annegautham/STM/README.md

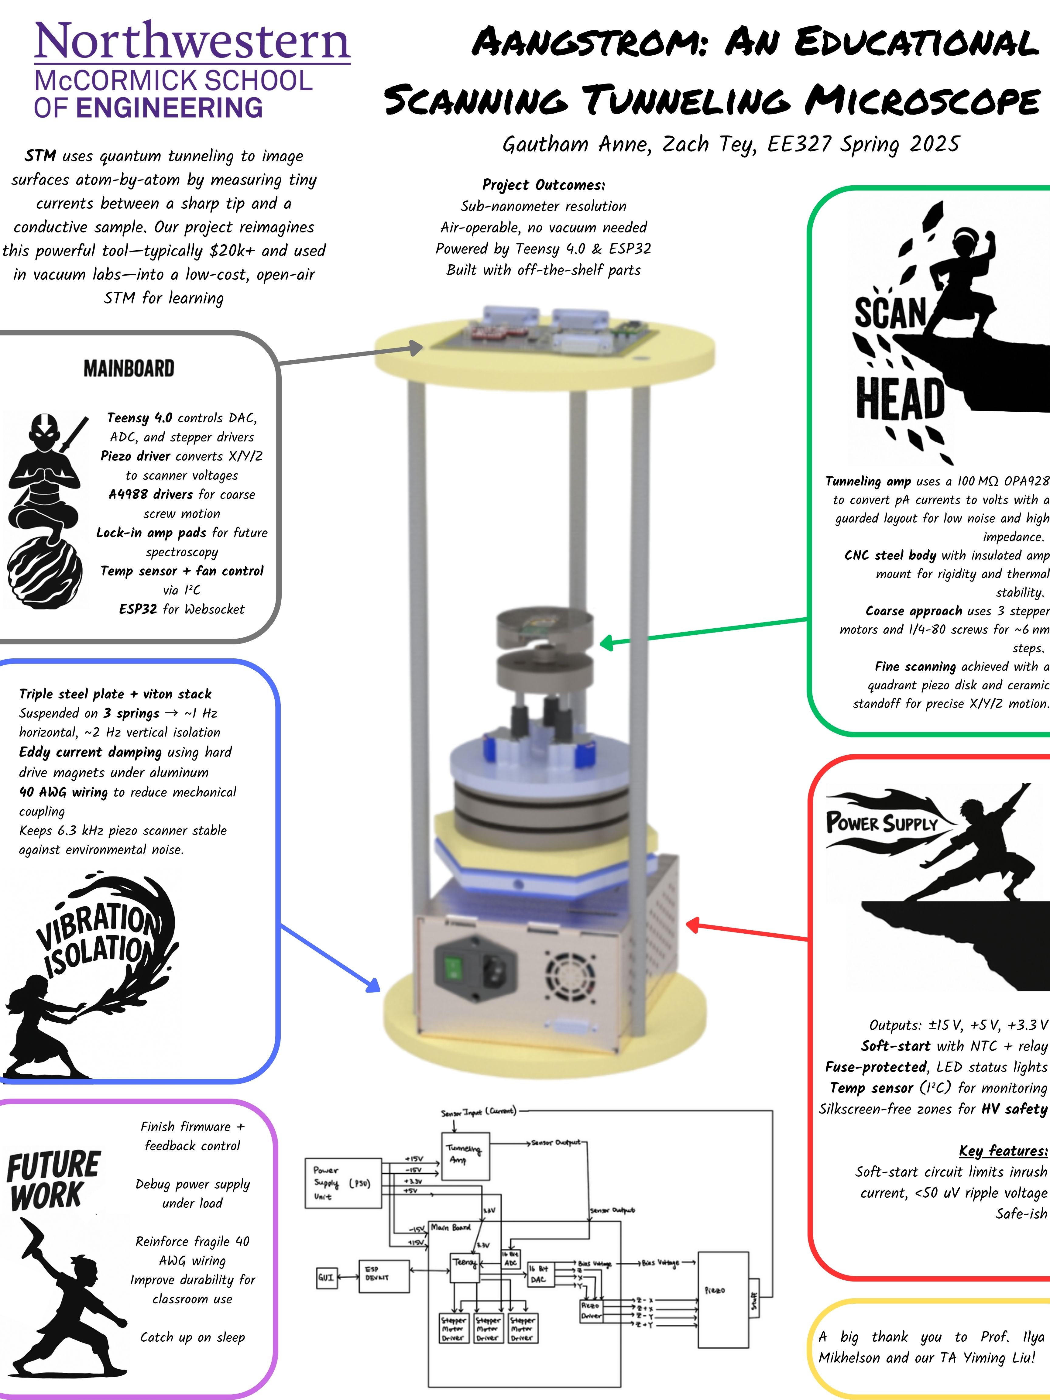
[picture p1: EE327FinalPoster.jpg]

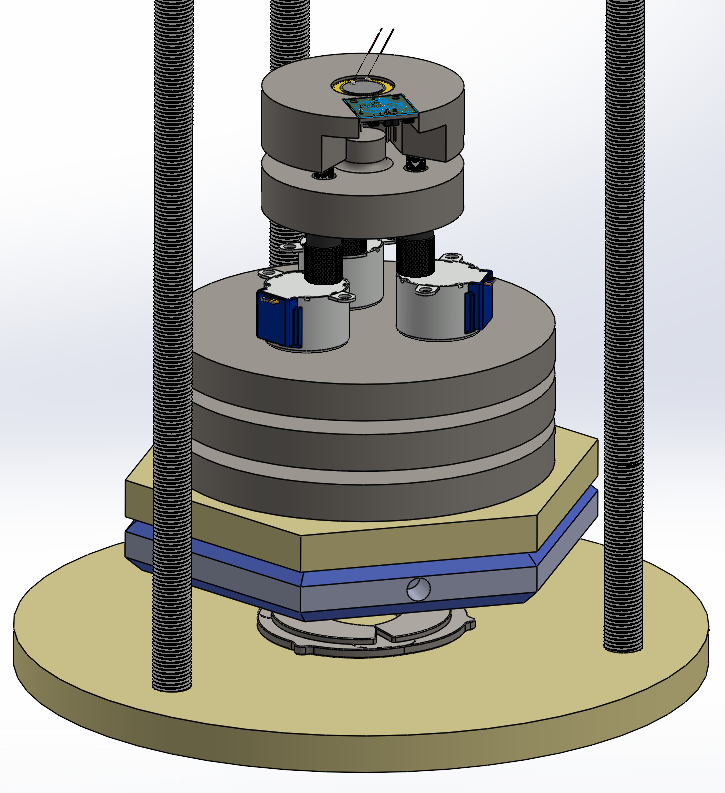
[picture p2: setup.png]
