annegautham/STM/Scan Head/28-BYJ48/28BYJ-48 stepper motor 5VDC.jpg

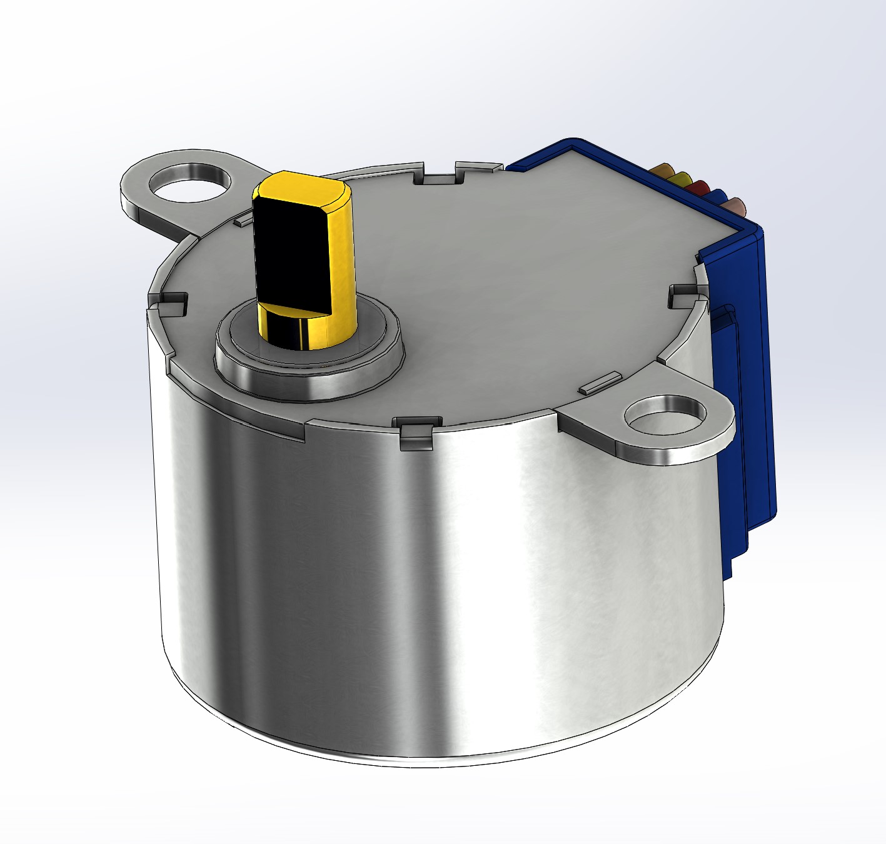
Scan Head/28-BYJ48/28BYJ-48 stepper motor 5VDC.jpg
