annegautham/STM/Scan Head/28-BYJ48/28BYJ-48 stepper motor ASSEMBLY.SLDASM

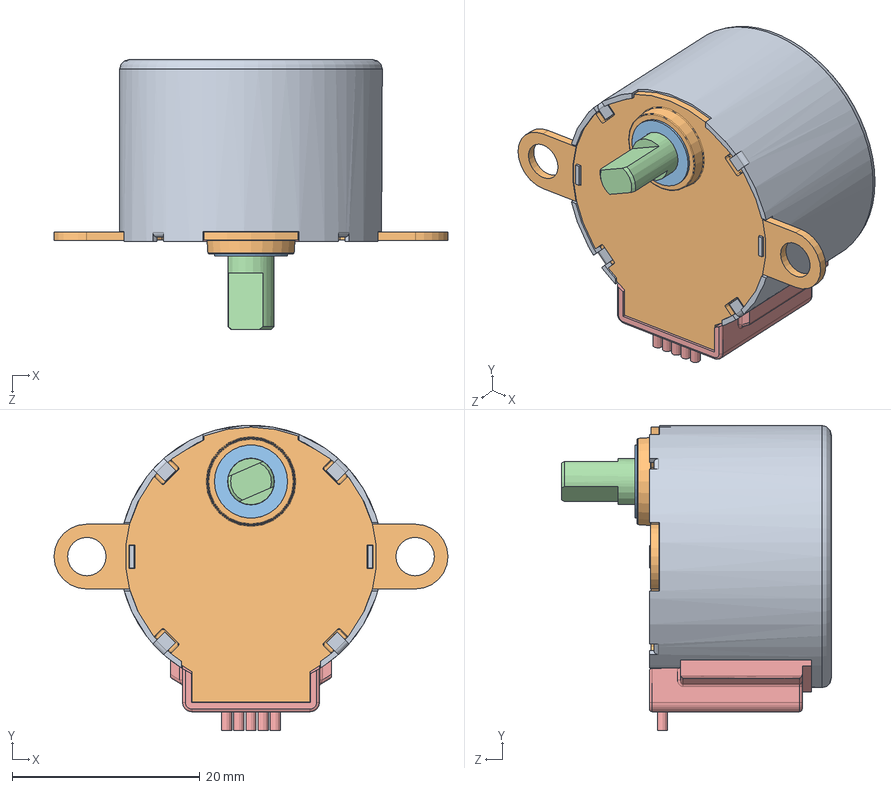
[picture p4: CAD file, 2025-05-25]
Scan Head/28-BYJ48/28BYJ-48 stepper motor ASSEMBLY.SLDASM
42.0 x 32.5 x 28.8 mm
28BYJ-48 body
28BYJ-48 cover plate
Teflon D8d5
28BYJ-48 shaft
28BYJ-48 plastic
