annegautham/STM/Mainboard/casing.SLDPRT

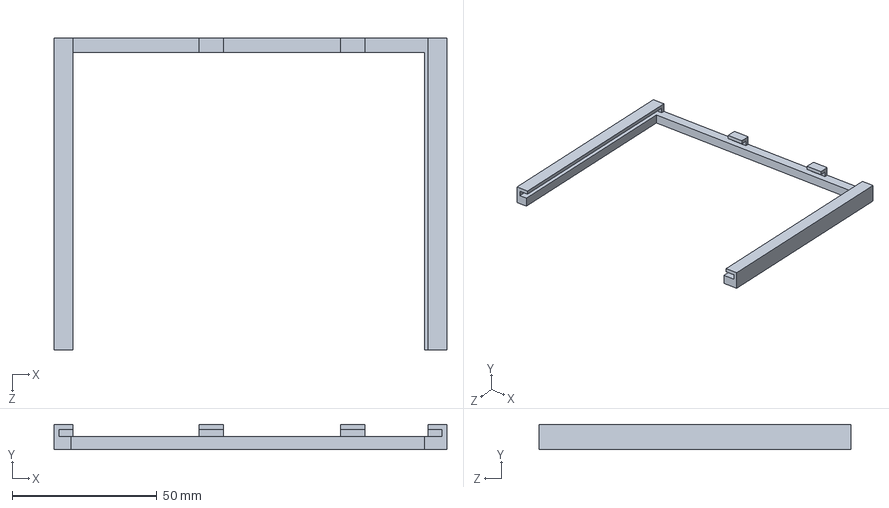
[picture p5: CAD file, 2025-06-02]
Mainboard/casing.SLDPRT
135.6 x 8.75 x 107.8 mm
