annegautham/STM/Power_Supply/CAD/Power_Supply_Case.SLDPRT

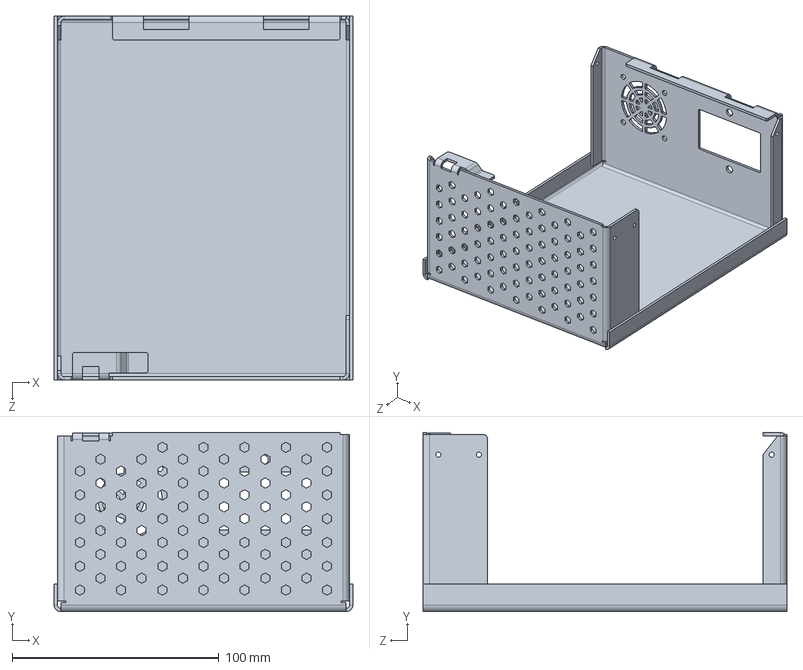
[picture p6: CAD file, 2025-06-02]
Power_Supply/CAD/Power_Supply_Case.SLDPRT
144.6 x 86.6 x 176.0 mm
