annegautham/STM/Scan Head/28-BYJ48/28BYJ-48 cover plate.SLDPRT

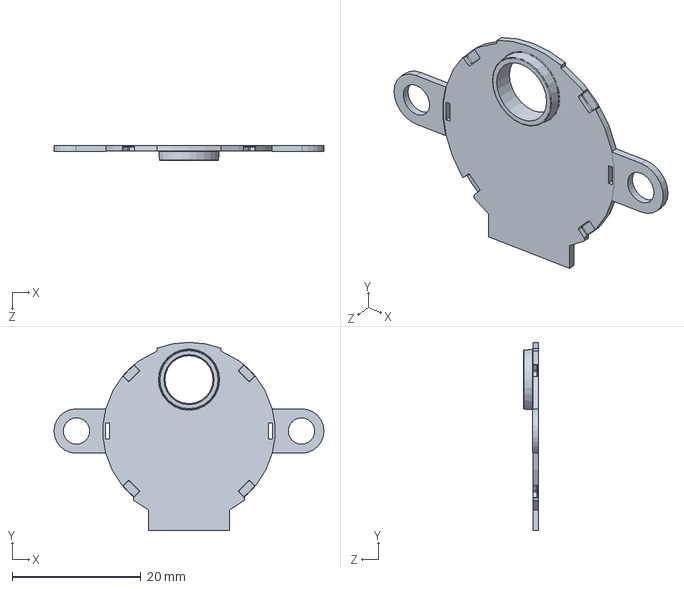
[picture p7: CAD file, 2025-05-25]
Scan Head/28-BYJ48/28BYJ-48 cover plate.SLDPRT
42.0 x 29.3 x 2.35 mm
