annegautham/STM/Scan Head/Top.SLDPRT

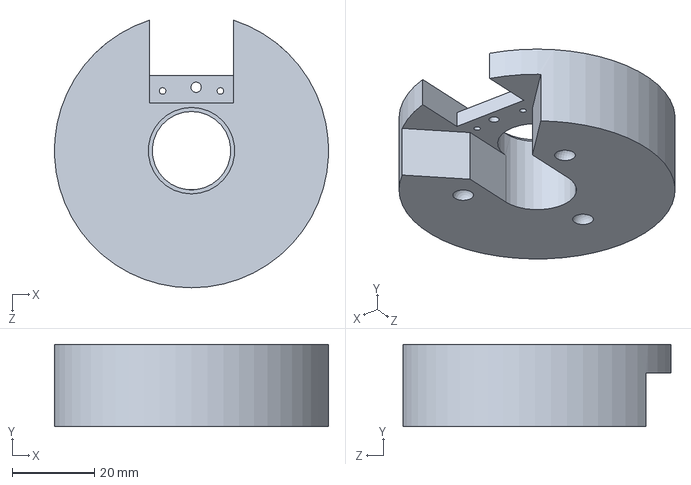
[picture p8: CAD file, 2025-05-30]
Scan Head/Top.SLDPRT
66.6 x 20.0 x 65.0 mm
