annegautham/STM/support_mot_pap.SLDPRT

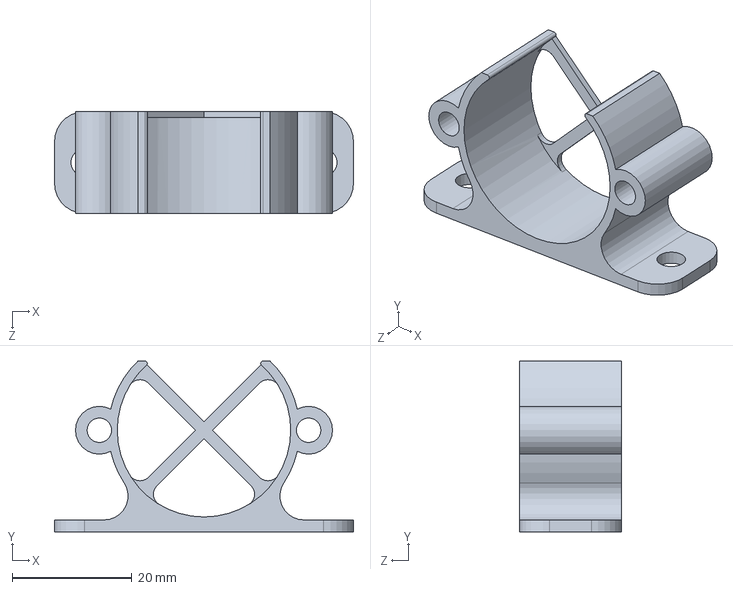
[picture p9: CAD file, 2025-11-16]
support_mot_pap.SLDPRT
50.0 x 28.6 x 17.0 mm
