annegautham/STM/Vibration Isolation/steelEyeM10x20.step

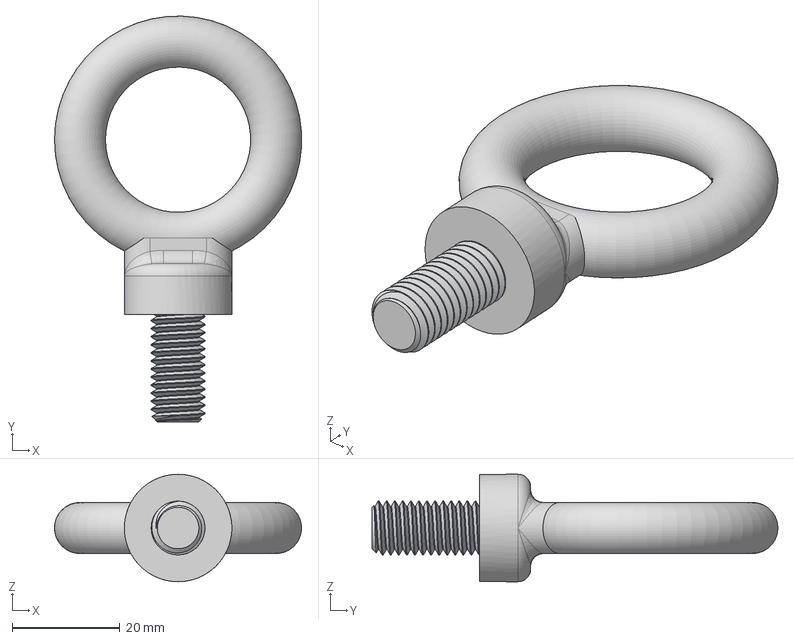
[picture p10: CAD file, 2025-06-02]
Vibration Isolation/steelEyeM10x20.step
45.9 x 75.5 x 20.0 mm
