annegautham/STM/Power_Supply/CAD/TopCover.SLDPRT

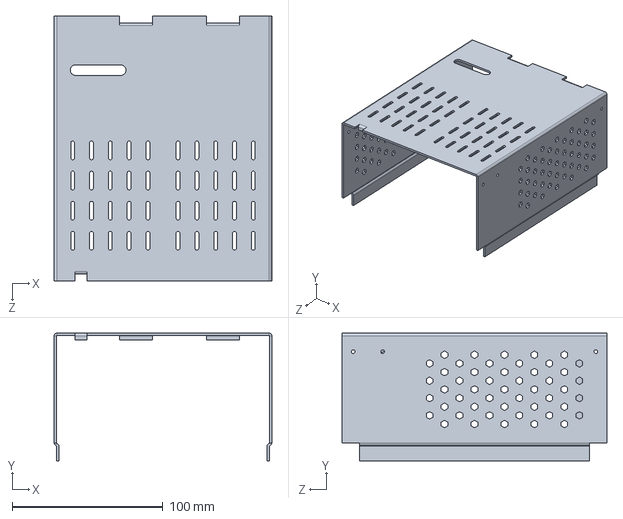
[picture p11: CAD file, 2025-05-28]
Power_Supply/CAD/TopCover.SLDPRT
144.6 x 85.0 x 176.0 mm
