annegautham/STM/Scan Head/Base.SLDPRT

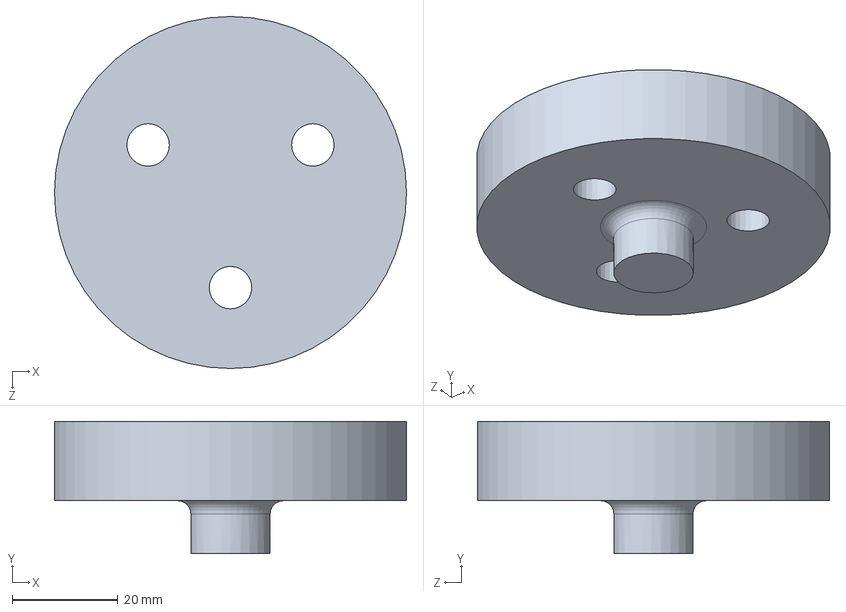
[picture p12: CAD file, 2025-05-25]
Scan Head/Base.SLDPRT
66.6 x 25.0 x 66.6 mm
