annegautham/STM/spider.SLDPRT

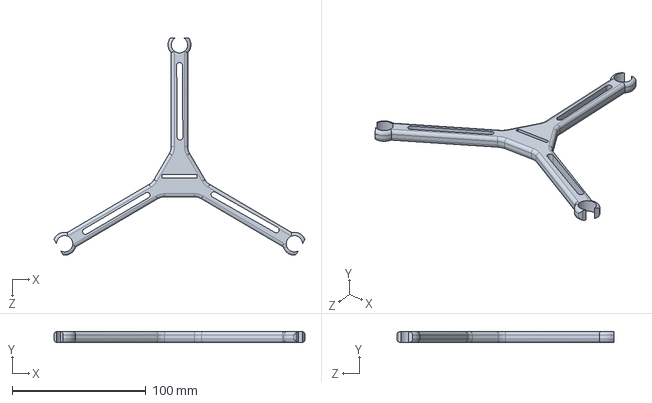
[picture p13: CAD file, 2025-11-16]
spider.SLDPRT
188.0 x 8.00 x 162.8 mm
