annegautham/STM/Vibration Isolation/mdf_ground.SLDPRT

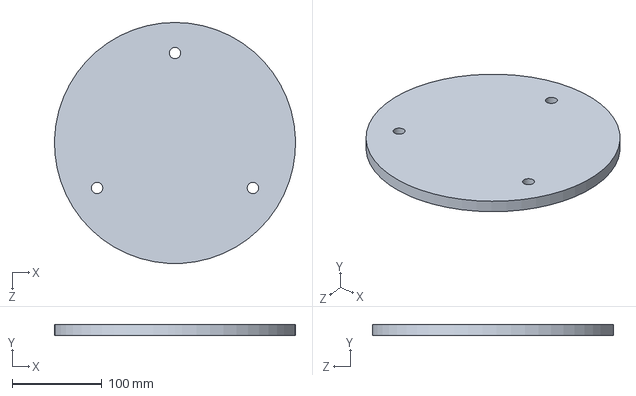
[picture p14: CAD file, 2025-06-02]
Vibration Isolation/mdf_ground.SLDPRT
267.9 x 12.7 x 268.0 mm
