annegautham/STM/Power_Supply/CAD/Flat pattern - Power_Supply_Case.DXF

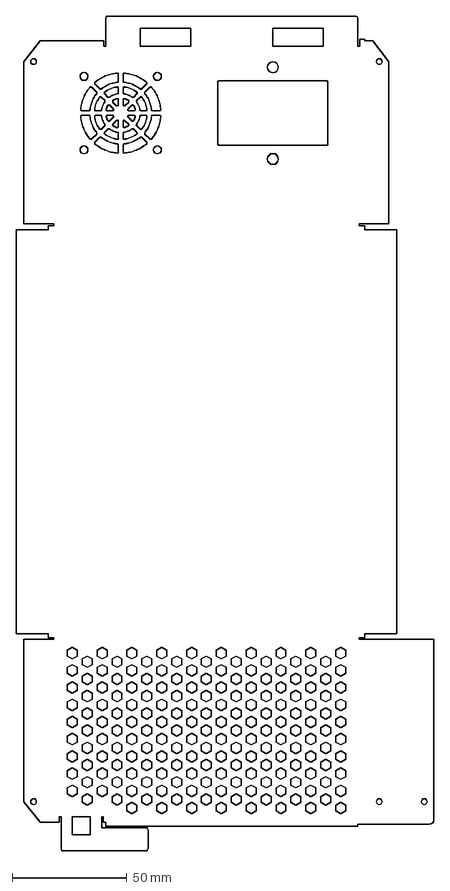
[picture p15: CAD file, 2025-04-13]
Power_Supply/CAD/Flat pattern - Power_Supply_Case.DXF
182.1 x 363.5 mm
