annegautham/STM/Scan Head/base_interconnect.SLDPRT

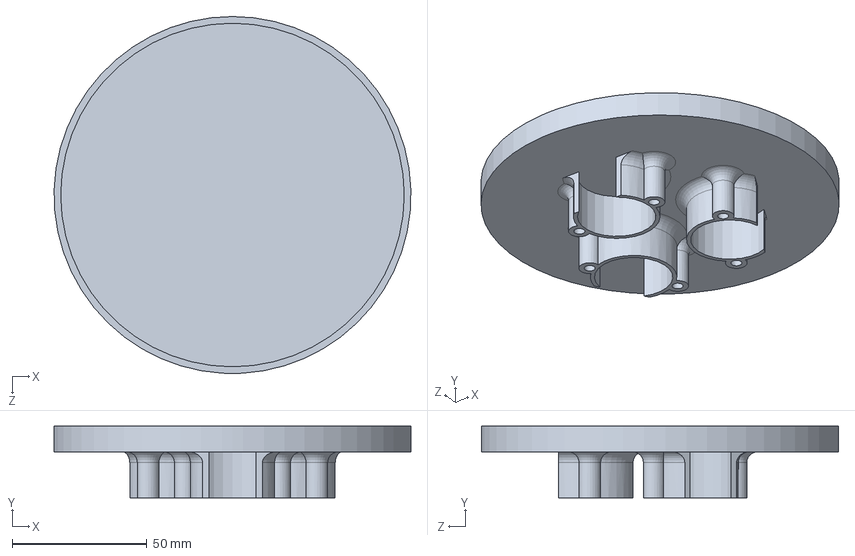
[picture p16: CAD file, 2025-05-25]
Scan Head/base_interconnect.SLDPRT
132.2 x 26.5 x 132.2 mm
