annegautham/STM/Vibration Isolation/eyehook.SLDPRT

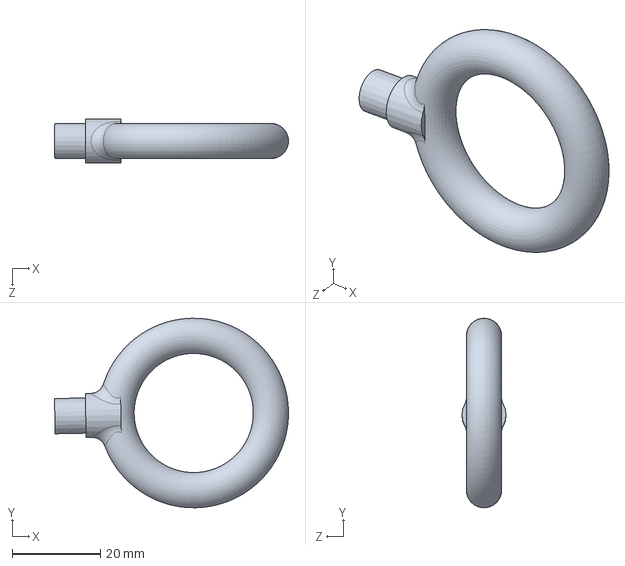
[picture p17: CAD file, 2025-06-02]
Vibration Isolation/eyehook.SLDPRT
53.1 x 43.0 x 10.0 mm
