annegautham/STM/Power_Supply/CAD/Flat pattern - TopCover.DXF

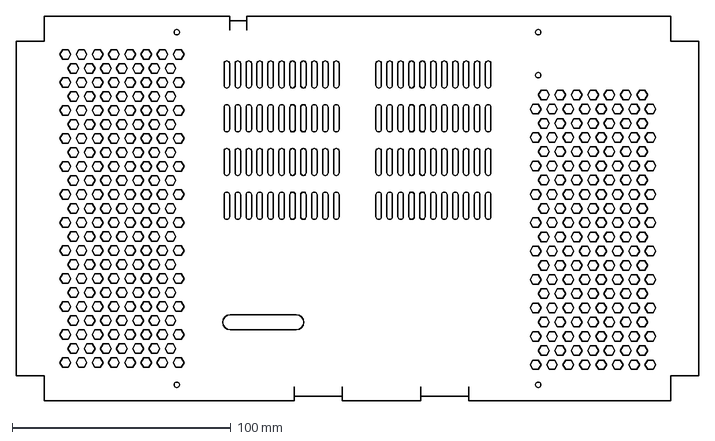
[picture p18: CAD file, 2025-04-13]
Power_Supply/CAD/Flat pattern - TopCover.DXF
311.9 x 176.0 mm
