annegautham/STM/Scan Head/28-BYJ48/28BYJ-48 body.SLDPRT

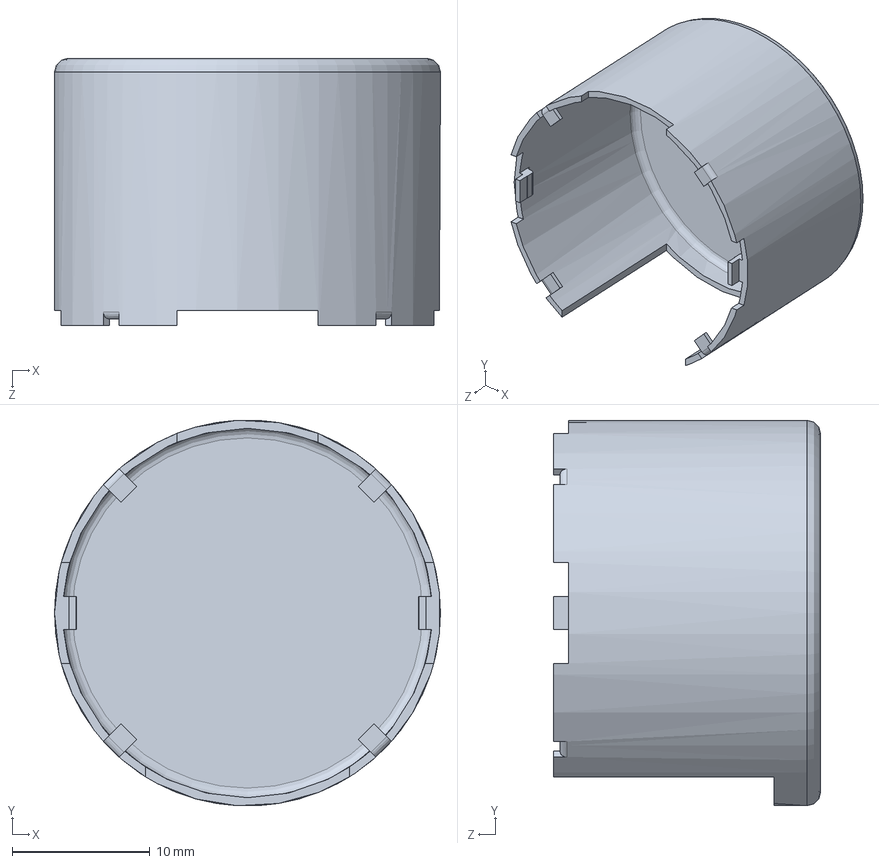
[picture p19: CAD file, 2025-04-18]
Scan Head/28-BYJ48/28BYJ-48 body.SLDPRT
28.0 x 28.0 x 19.4 mm
