annegautham/STM/Scan Head/collet.SLDPRT

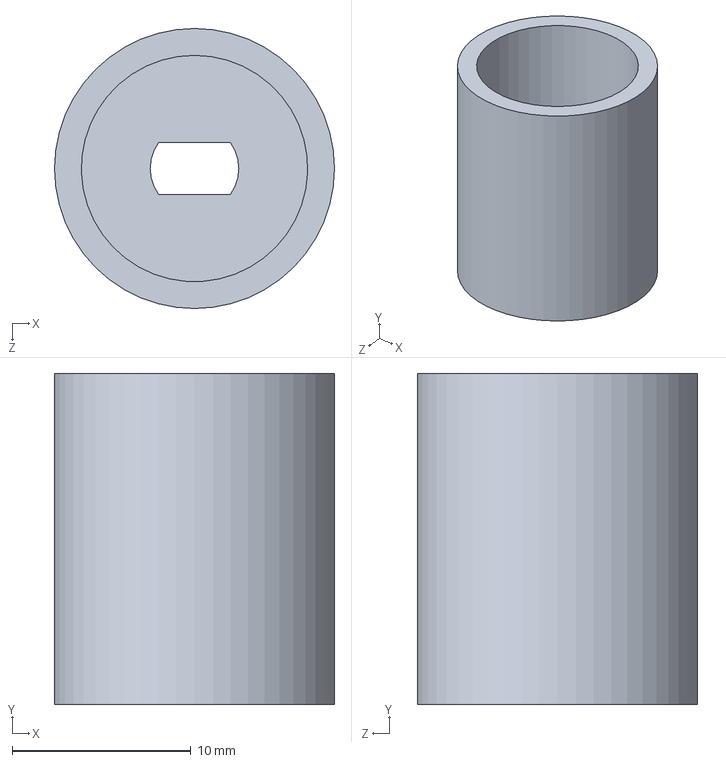
[picture p20: CAD file, 2025-05-18]
Scan Head/collet.SLDPRT
15.7 x 18.5 x 15.7 mm
