annegautham/STM/Power_Supply/CAD/Power Entry AC 10A 250V IEC320 C14 Illuminated.STEP

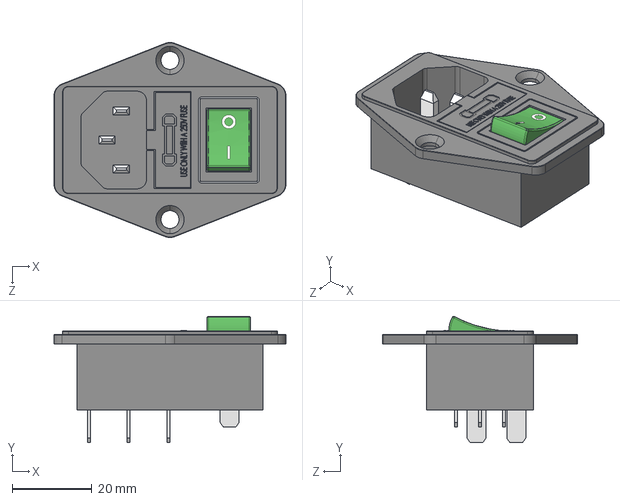
[picture p21: CAD file, 2025-04-04]
Power_Supply/CAD/Power Entry AC 10A 250V IEC320 C14 Illuminated.STEP
58.3 x 31.7 x 49.0 mm
