annegautham/STM/Scan Head/28-BYJ48/28BYJ-48 plastic.SLDPRT

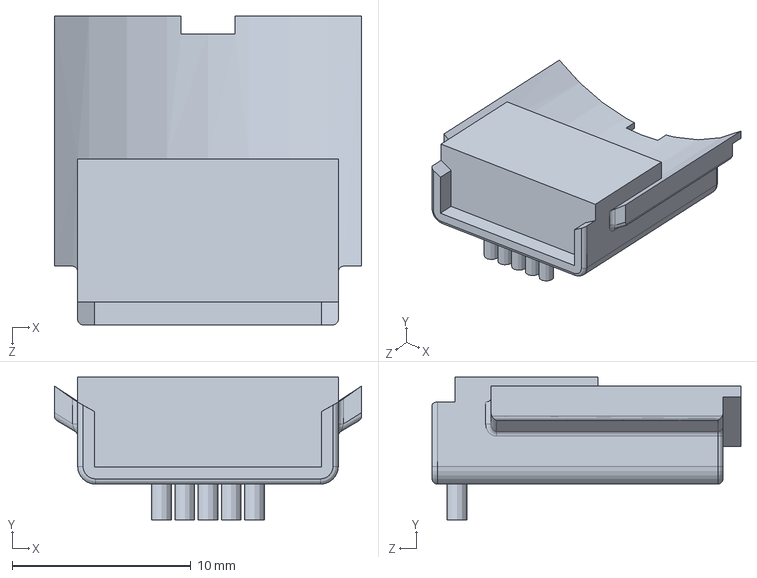
[picture p22: CAD file, 2025-04-18]
Scan Head/28-BYJ48/28BYJ-48 plastic.SLDPRT
17.2 x 8.00 x 17.3 mm
