annegautham/STM/Vibration Isolation/tipGuard.SLDPRT

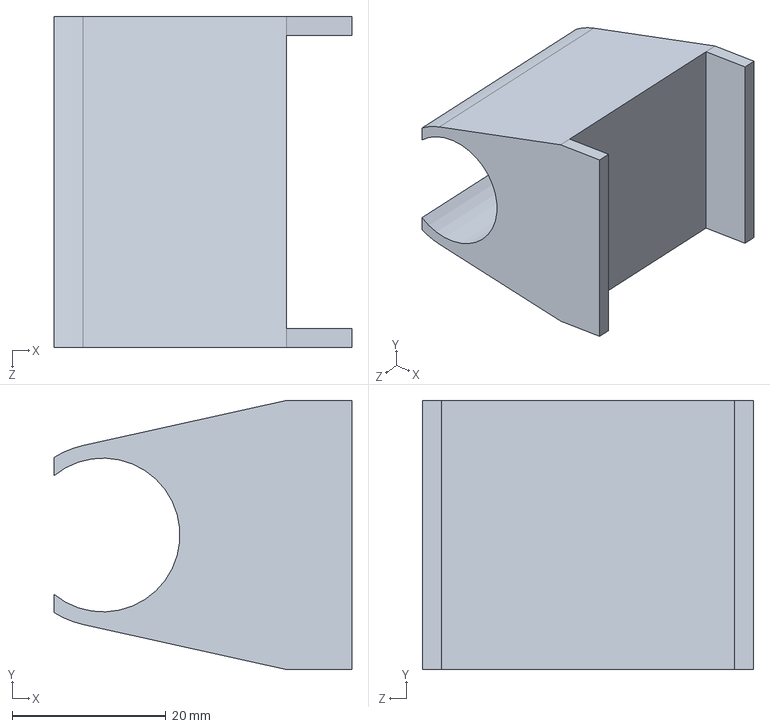
[picture p24: CAD file, 2025-05-29]
Vibration Isolation/tipGuard.SLDPRT
38.7 x 35.0 x 43.1 mm
