annegautham/STM/Power_Supply/CAD/40x40x10 DC Fan.SLDPRT

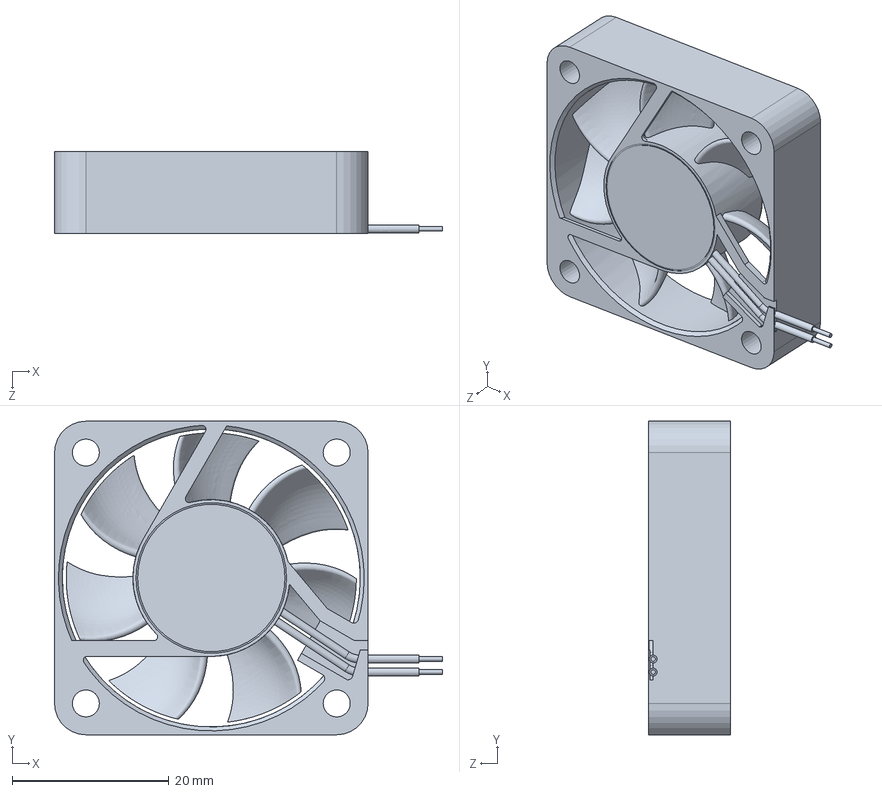
[picture p25: CAD file, 2025-04-04]
Power_Supply/CAD/40x40x10 DC Fan.SLDPRT
49.5 x 40.0 x 10.5 mm
