annegautham/STM/Scan Head/28-BYJ48/28BYJ-48 shaft.SLDPRT

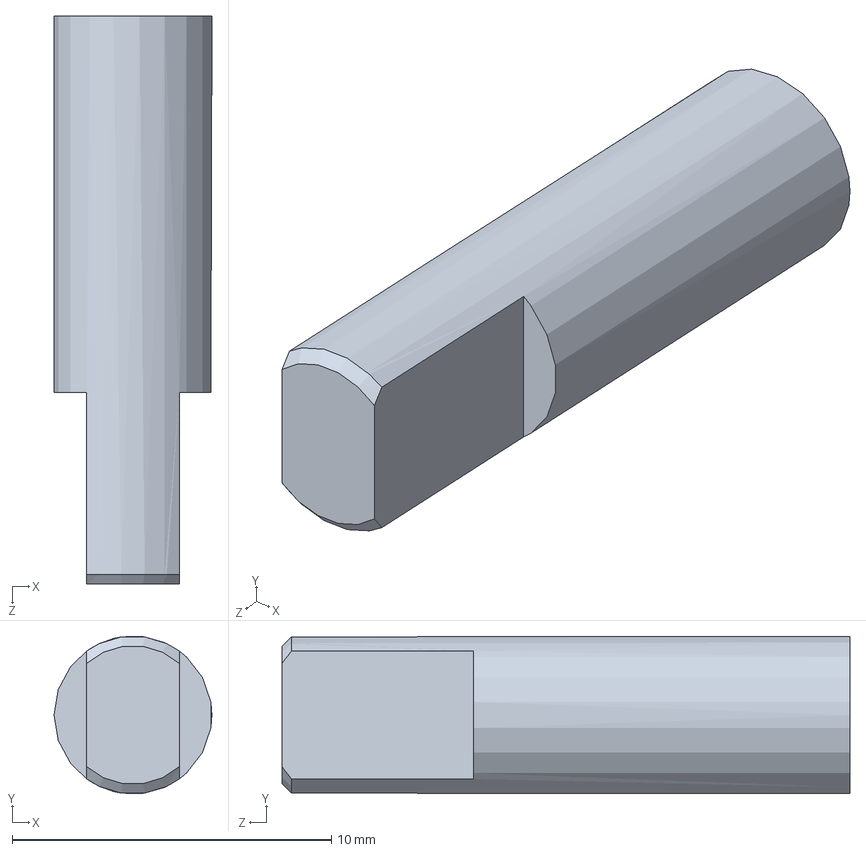
[picture p26: CAD file, 2025-04-18]
Scan Head/28-BYJ48/28BYJ-48 shaft.SLDPRT
4.95 x 4.93 x 17.8 mm
