annegautham/STM/Scan Head/tunneling_amp_insulation.SLDPRT

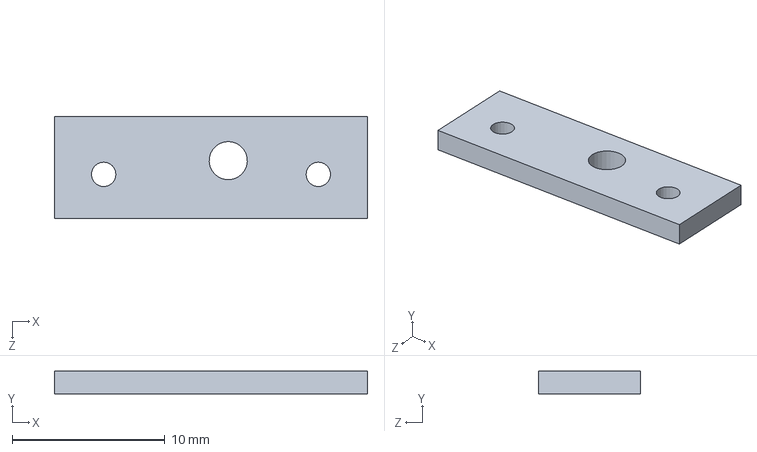
[picture p27: CAD file, 2025-04-23]
Scan Head/tunneling_amp_insulation.SLDPRT
20.5 x 1.50 x 6.70 mm
