annegautham/STM/Vibration Isolation/mdf_base.SLDPRT

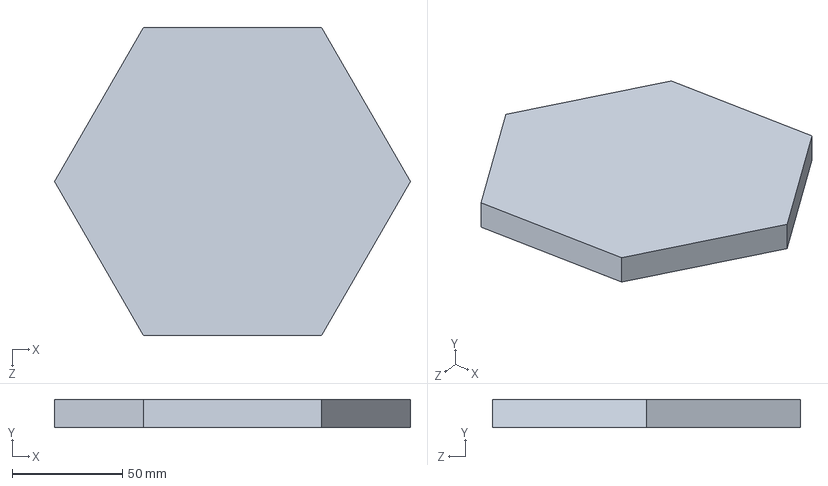
[picture p28: CAD file, 2025-05-02]
Vibration Isolation/mdf_base.SLDPRT
161.3 x 12.7 x 139.7 mm
