annegautham/STM/Power_Supply/CAD/FLN_40_18_model.STEP

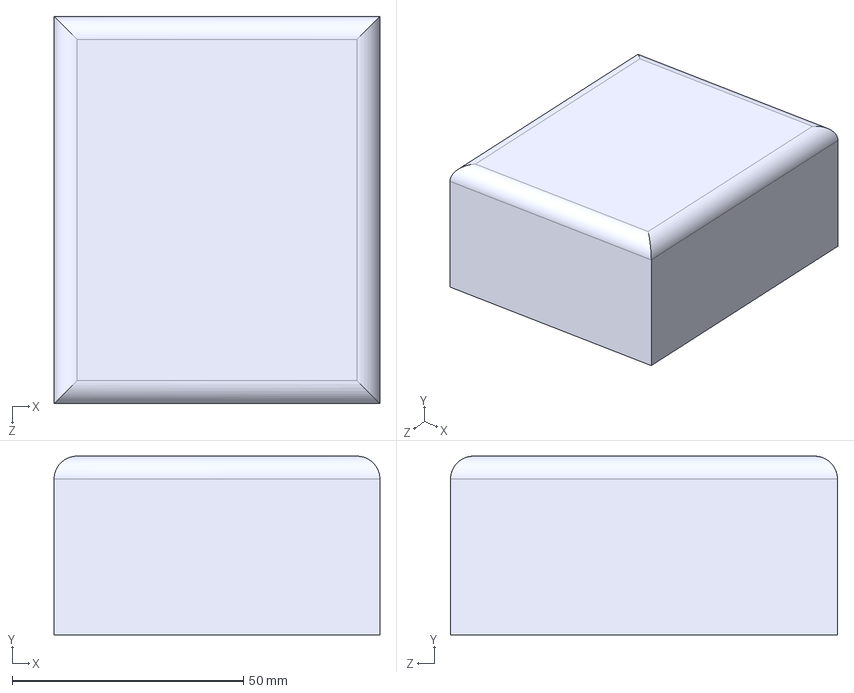
[picture p29: CAD file, 2025-04-04]
Power_Supply/CAD/FLN_40_18_model.STEP
70.5 x 38.7 x 83.7 mm
