annegautham/STM/Scan Head/28-BYJ48/Teflon D8d5.SLDPRT

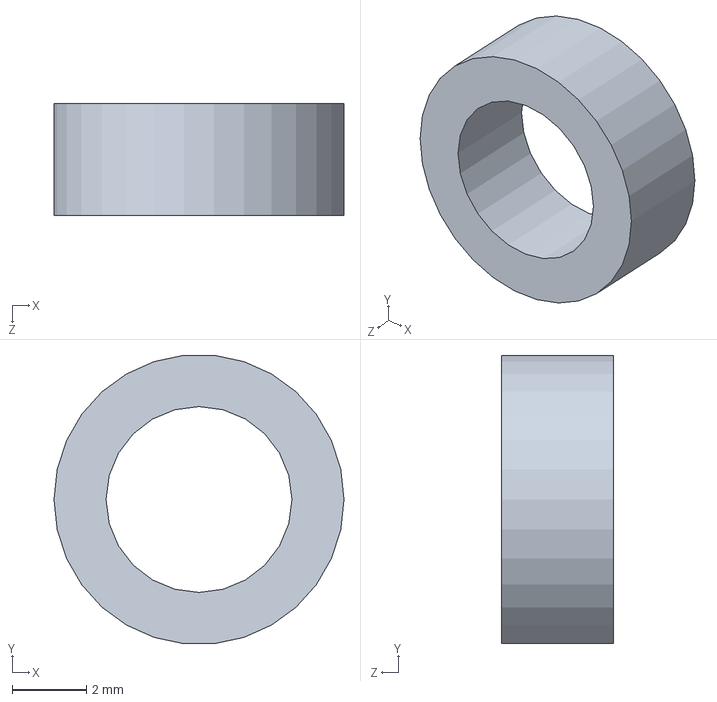
[picture p30: CAD file, 2025-04-18]
Scan Head/28-BYJ48/Teflon D8d5.SLDPRT
7.80 x 7.76 x 3.00 mm
