annegautham/STM/Scan Head/top_polycarb.SLDPRT

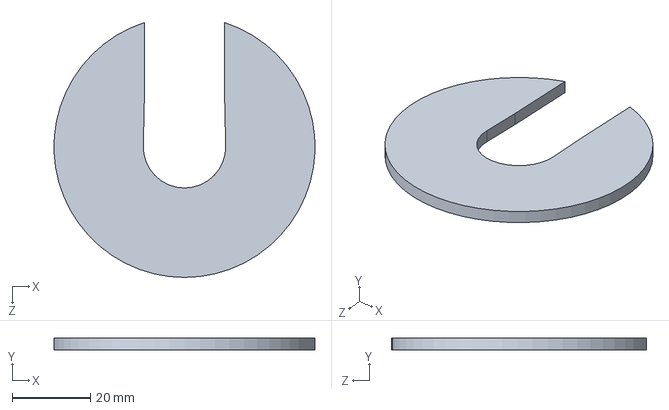
[picture p31: CAD file, 2025-04-23]
Scan Head/top_polycarb.SLDPRT
66.6 x 3.17 x 65.0 mm
