annegautham/STM/Vibration Isolation/hd_magnet.SLDPRT

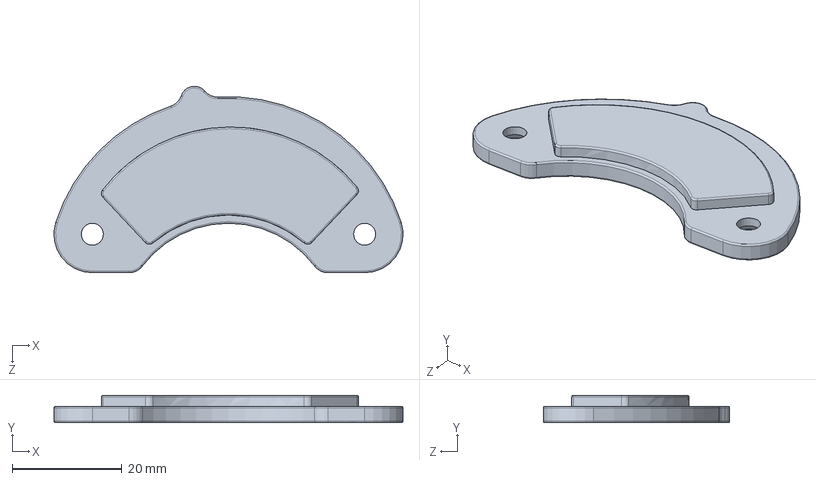
[picture p32: CAD file, 2025-05-02]
Vibration Isolation/hd_magnet.SLDPRT
63.5 x 5.00 x 33.9 mm
