annegautham/STM/Vibration Isolation/oring.SLDPRT

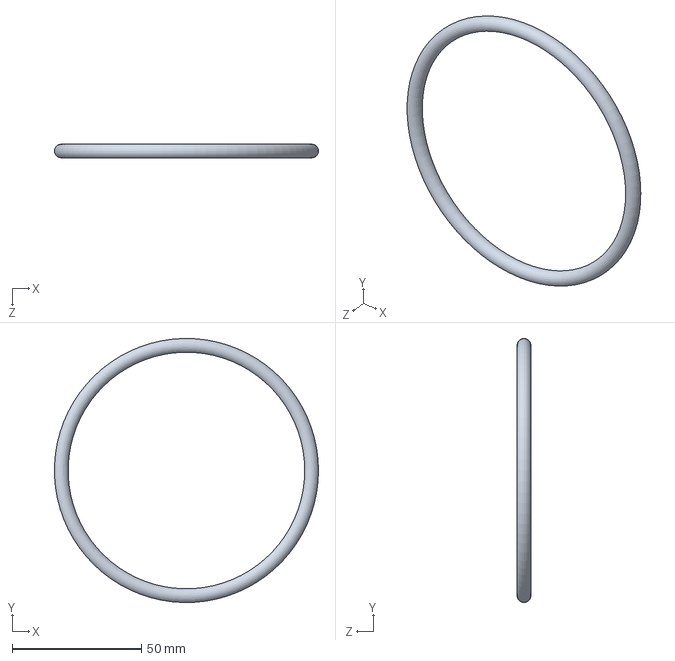
[picture p33: CAD file, 2025-05-02]
Vibration Isolation/oring.SLDPRT
102.1 x 102.1 x 5.33 mm
