annegautham/STM/Scan Head/AB2063B-2-LW50.STEP

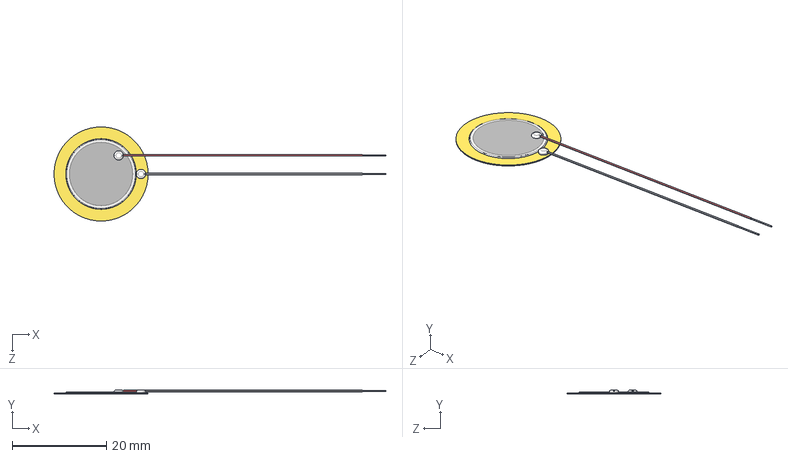
[picture p34: CAD file, 2025-04-18]
Scan Head/AB2063B-2-LW50.STEP
70.6 x 0.85 x 20.0 mm
AB2720B-LW100-R^Lead+Wires+++Glue v1_AB2063B-2-LW50(2)_AB2063B-2-LW50
AB4122B-LW50 test^AB2063B-2-LW50(2)_AB2063B-2-LW50
