annegautham/STM/Vibration Isolation/5in_plate.SLDPRT

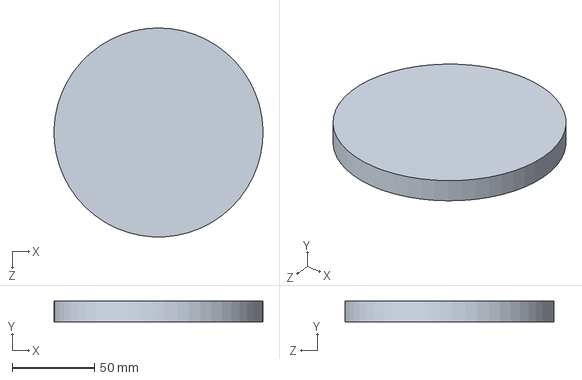
[picture p35: CAD file, 2025-05-02]
Vibration Isolation/5in_plate.SLDPRT
126.9 x 12.7 x 127.0 mm
