annegautham/STM/Scan Head/brass_insert.SLDPRT

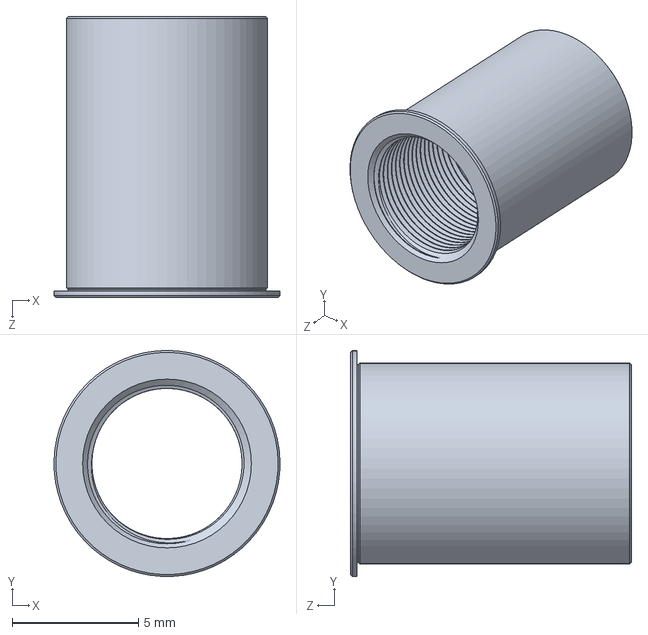
[picture p36: CAD file, 2025-04-18]
Scan Head/brass_insert.SLDPRT
8.94 x 8.94 x 11.1 mm
