annegautham/STM/Vibration Isolation/aluminum_baseplate.SLDPRT

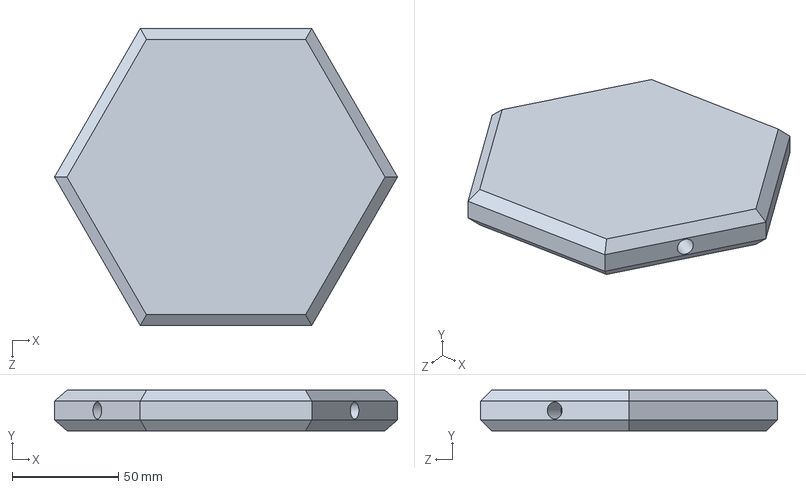
[picture p37: CAD file, 2025-05-02]
Vibration Isolation/aluminum_baseplate.SLDPRT
161.3 x 19.1 x 139.7 mm
