annegautham/STM/(list of files, cad)

Other CAD files:
Scan Head/28-BYJ48/28BYJ-48 stepper motor ASSEMBLY PART.SLDPRT
Scan Head/28-BYJ48/STEP IGS STL/28BYJ-48 stepper motor.STEP
Vibration Isolation/springs.SLDPRT
Mainboard/casing.3mf
Mainboard/casing.STL
Power_Supply/CAD/FLN_40_18_model.SLDPRT
Power_Supply/CAD/TopCover.STL
Scan Head/10151976.stp
Scan Head/28-BYJ48/STEP IGS STL/28BYJ-48 stepper motor.IGS
Scan Head/Top.DXF
Scan Head/Top.SLDDRW
Scan Head/base_interconnect.STL
Scan Head/bottom.SLDDRW
Scan Head/collet.STL
Scan Head/tunneling_amp_insulation.STL
Vibration Isolation/tipGuard.STL
