annegautham/STM/Power_Supply/plots/Power_Supply__Assembly.pdf

V1.1 | Dig 5V & ³.3V
-15V STM | Power | Supply

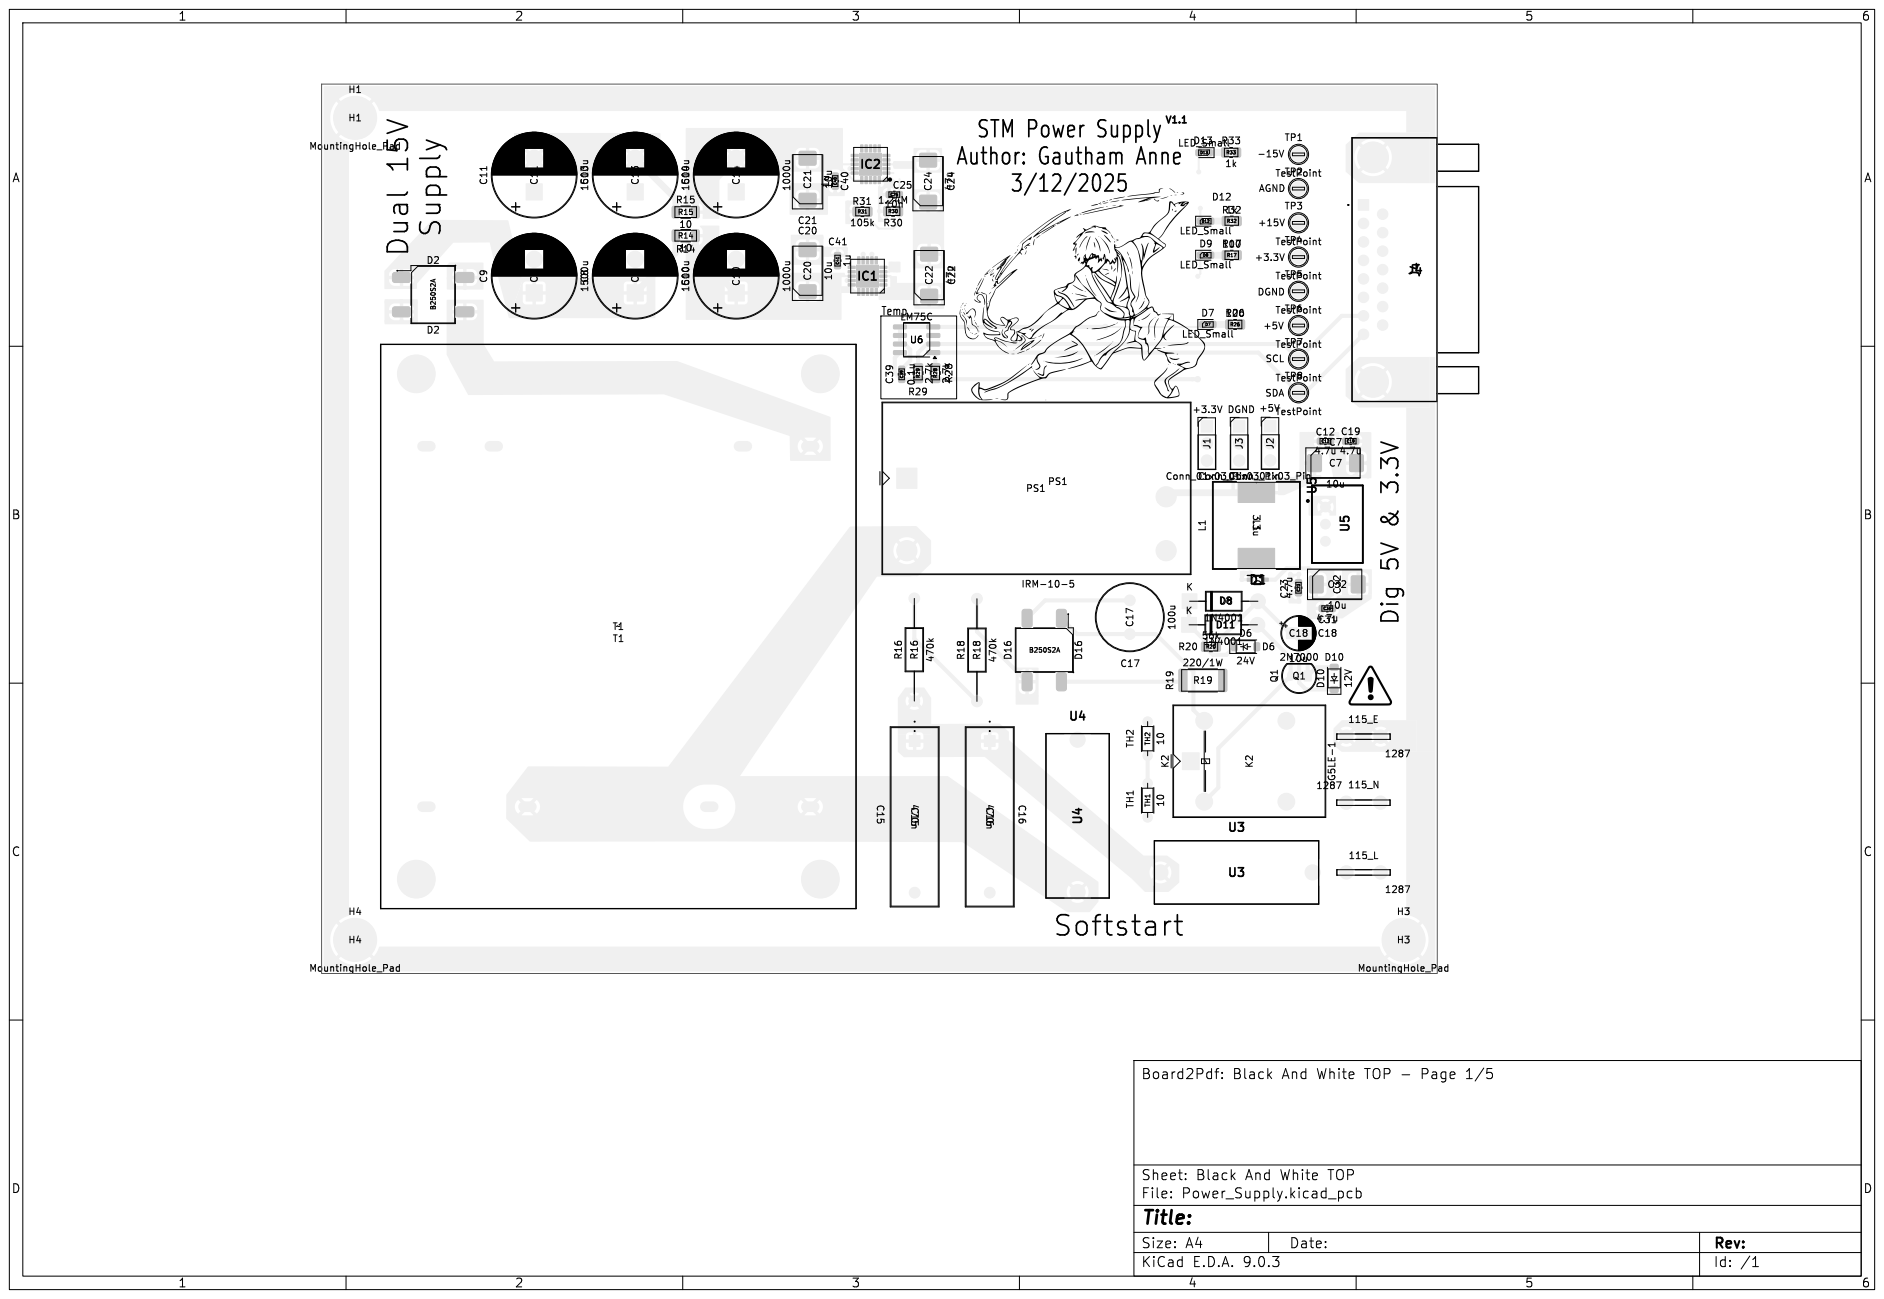
[picture p38: page 1]

Id: /1 Title: File: Power_Supply.kicad_pcb Sheet: Black And White TOP

1 | 2 | 3 | 4 | 5 | 6

A

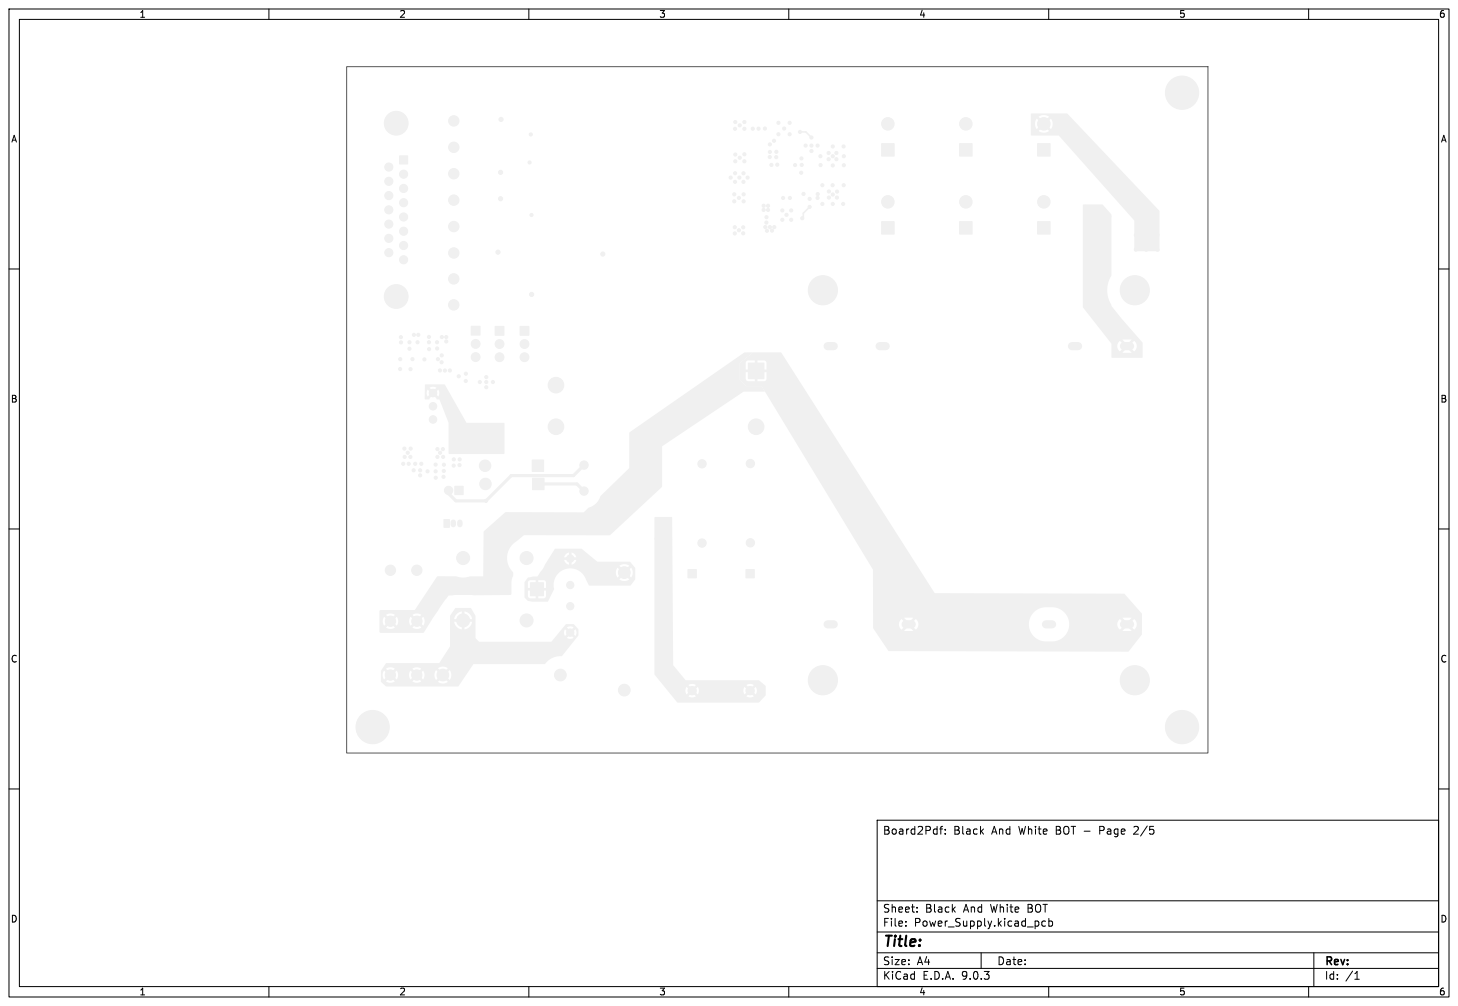
[picture p39: page 2]
D Date: KiCad; E.D.A. 9.0.3 Size: A4; Rev:; Id: /1 Title: File: Power_Supply.kicad_pcb Sheet: Black; And; White; BOT Board2Pdf:; Black; BOT -; Page 2/5

V1.1 | Dig 5V & ³.3V
-15V STM | Power | Supply

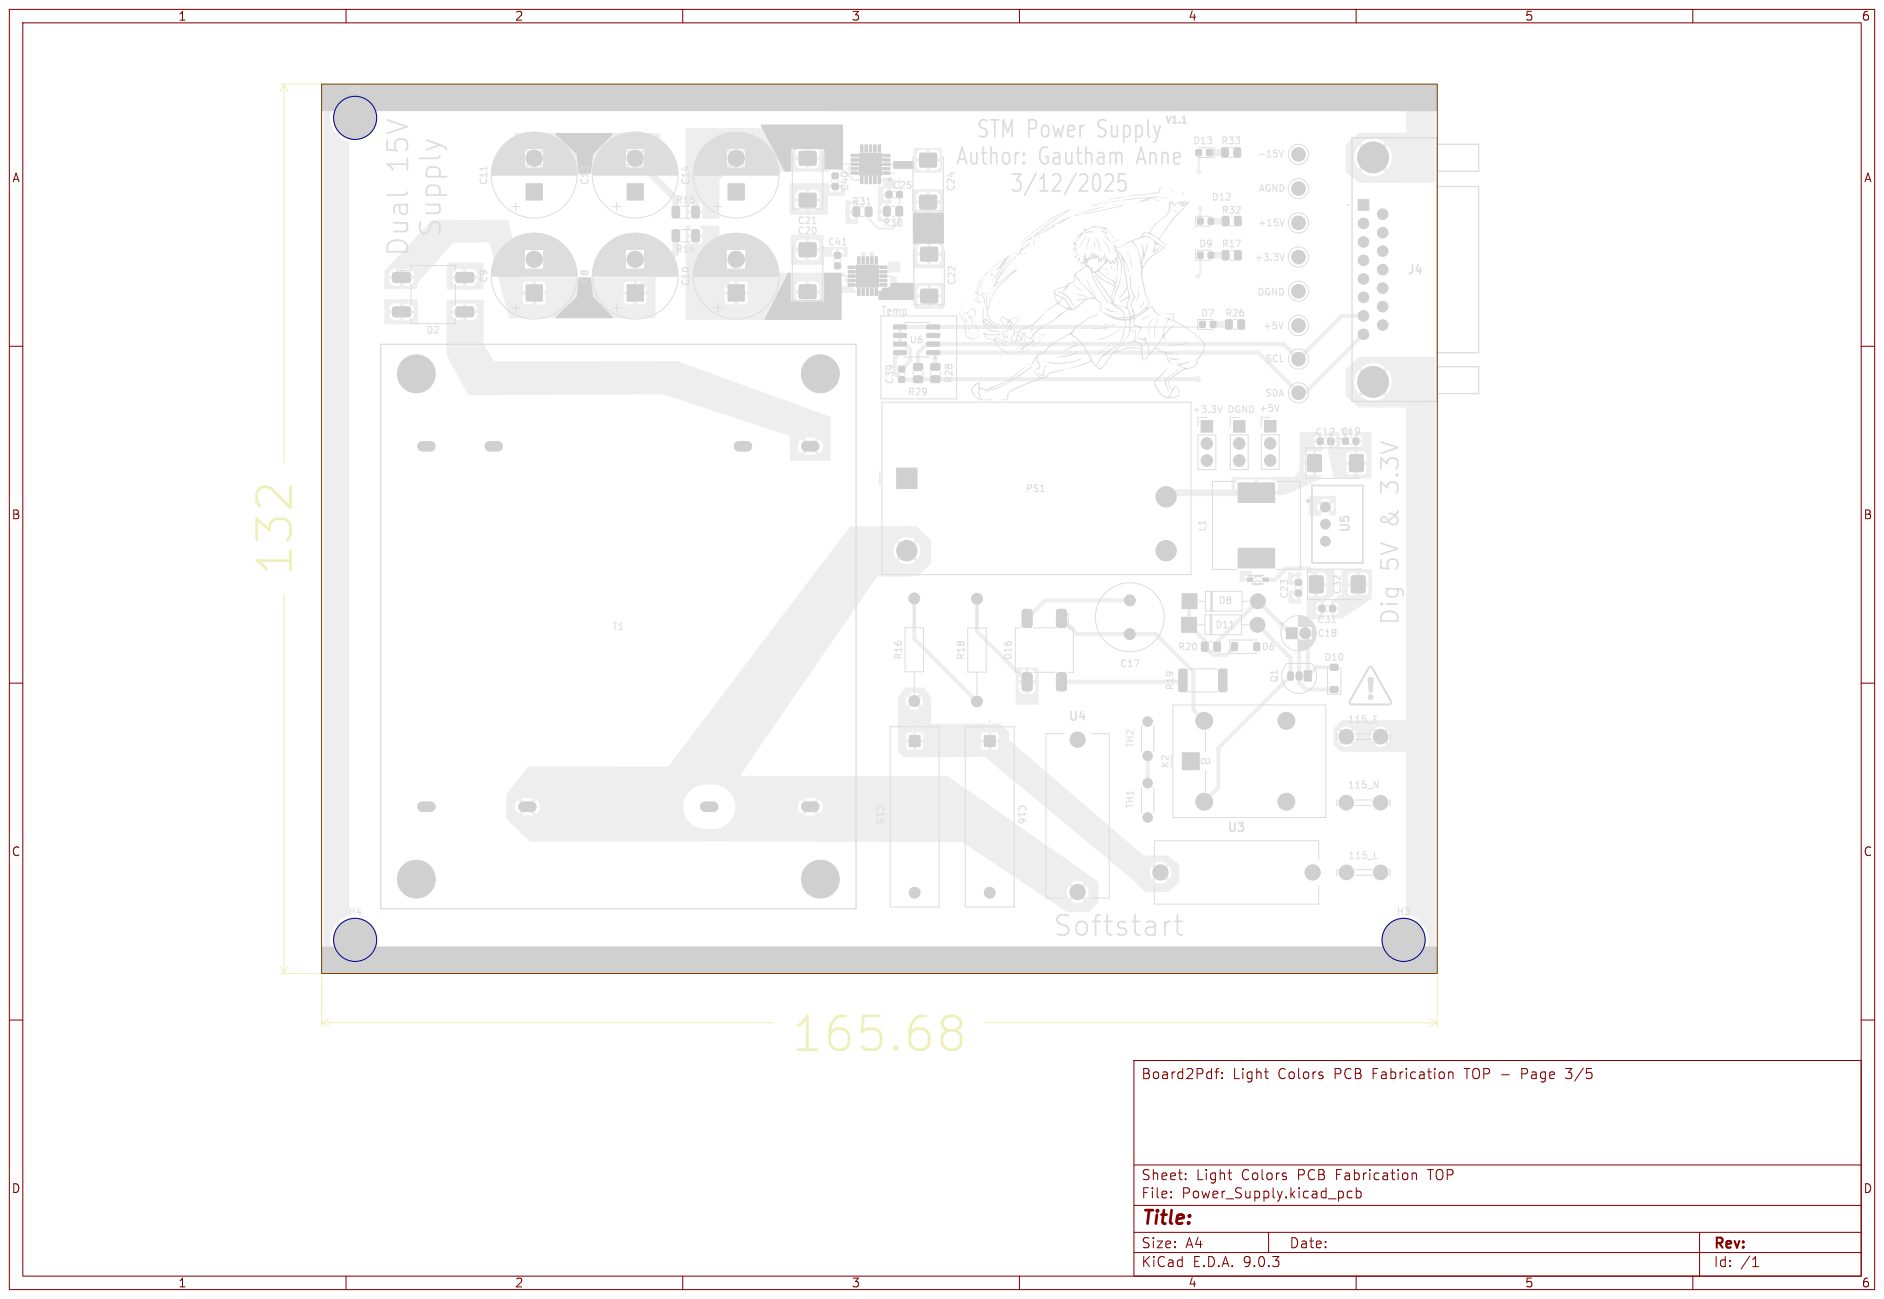
[picture p40: page 3]

1 | 2 | 3 | 4 | 5 | 6

A

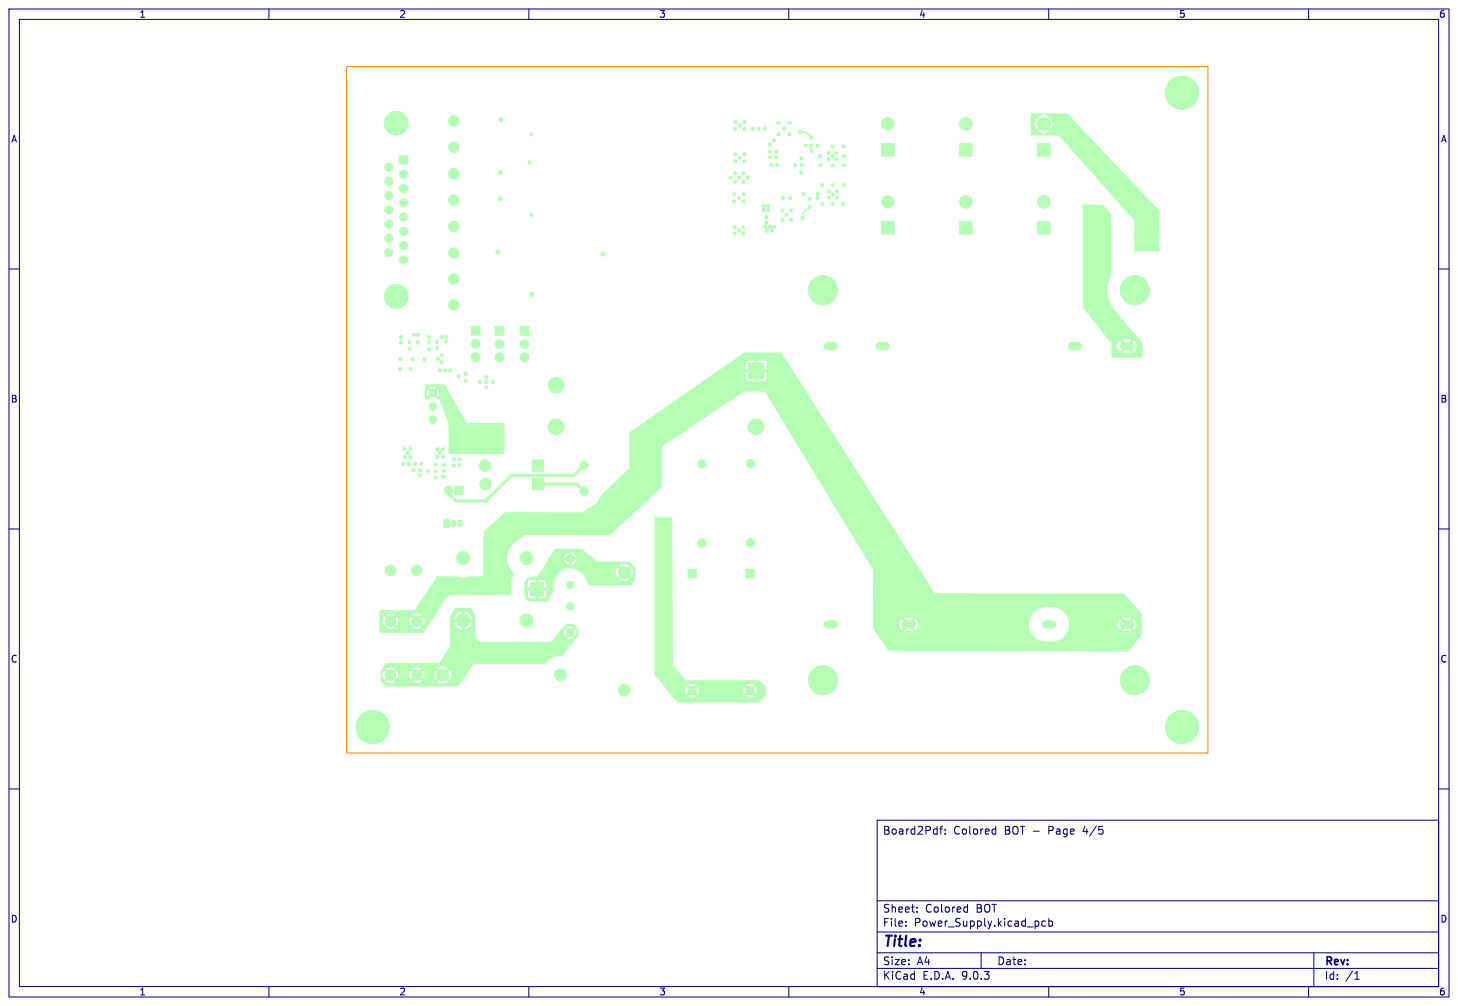
[picture p41: page 4]
D Date: KiCad; E.D.A. 9.0.3 Size: A4; Rev:; Id: /1 Title: File: Power_Supply.kicad_pcb Sheet: Colored; BOT Board2Pdf:; Colored; BOT -; Page 4/5

V1.1 | Dig 5V & ³.3V
-15V STM | Power | Supply

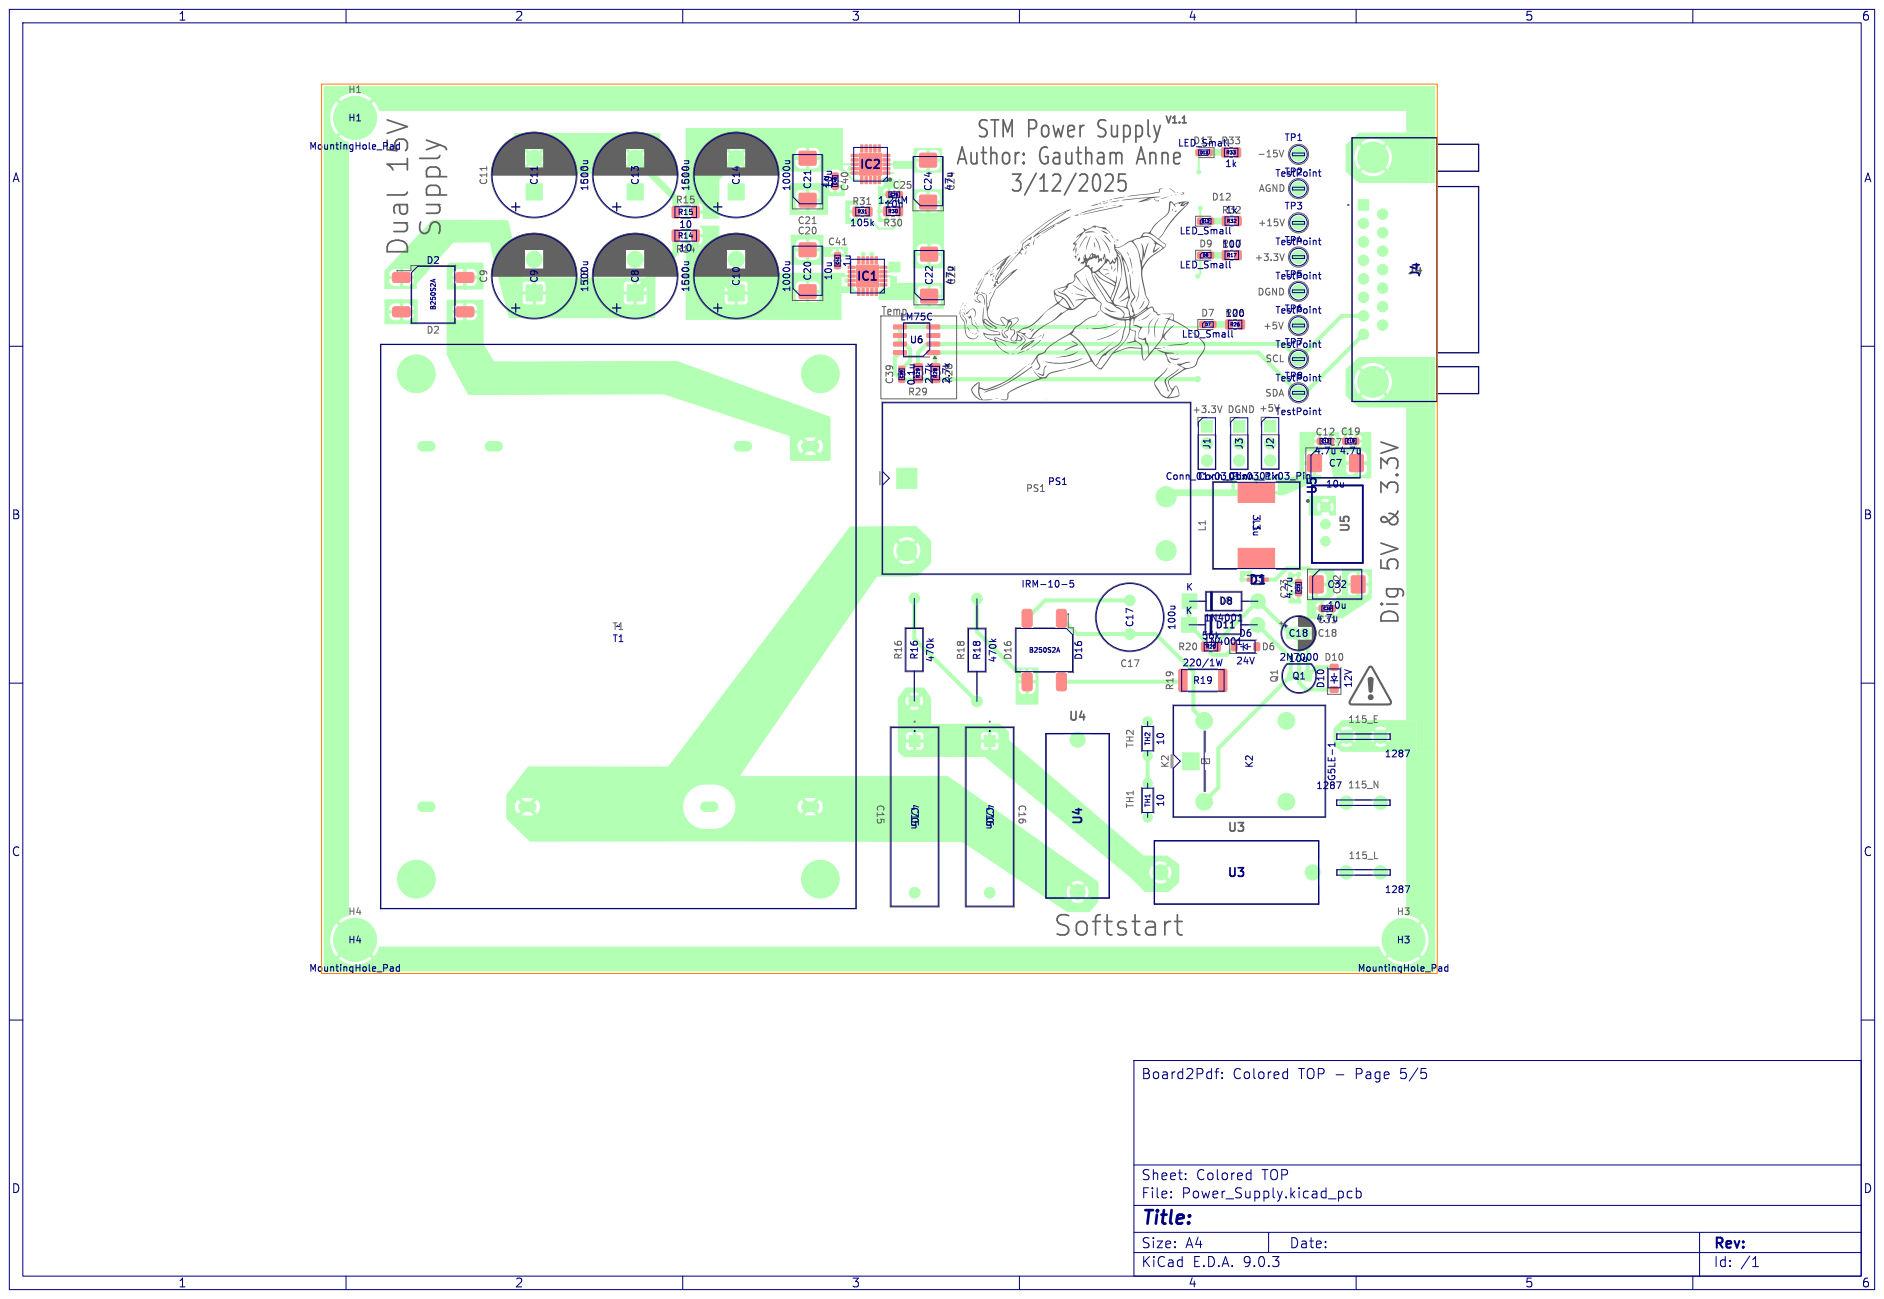
[picture p42: page 5]

Id: /1 Title: File: Power_Supply.kicad_pcb Sheet: Colored TOP
