annegautham/STM/Power_Supply/Spice Sim/Draft.asc

C1: cap; 1500µ
C2: cap; 1500µ
C3: cap; 1500µ
C4: cap; 1500µ
C5: cap; 1000µ
C6: cap; 1000µ
C7: cap; 0.1µ
C8: cap; 0.1µ
I1: current; 0.25
I2: current; 0.25
L1: ind2; 44.4444444; Rser=15.65
L2: ind2; 1
L3: ind2; 1
R1: res; 10
R2: res; 35
R4: res; 10
U1: b250s2a-slim
V1: voltage; SINE(0 169.705627 60)
Named nets: in, +, -, 0
.tran 1
(120/18)^2
(120/18)^2
.inc C:\\Users\\anneg\\Documents\\STM\\Power_Supply\\Spice Sim\\b250s2a-slim_spice.lib
K1 L1 L2 L3 1
120V rms = 120 * sqrt(2) = 169.7 p2p
