annegautham/STM/Power_Supply/Spice Sim/Draft1.asc

L1: ind2; 30; Rser=0.0001
L2: ind2; 1
R1: res; 3
V1: voltage; SINE(0 115 60)
Named nets: 0
K L1 L2 1
.tran 100m
