annegautham/STM/(list of files, drawings)

Other design files:
Mainboard/freerouting.dsn
Mainboard/temp-freerouting.dsn
