annegautham/STM/Tunneling_Amp/Tunnleing_Amp.kicad_pcb

## KiCad design Tunneling_Amp/Tunnleing_Amp.kicad_pcb (2025-05-08)

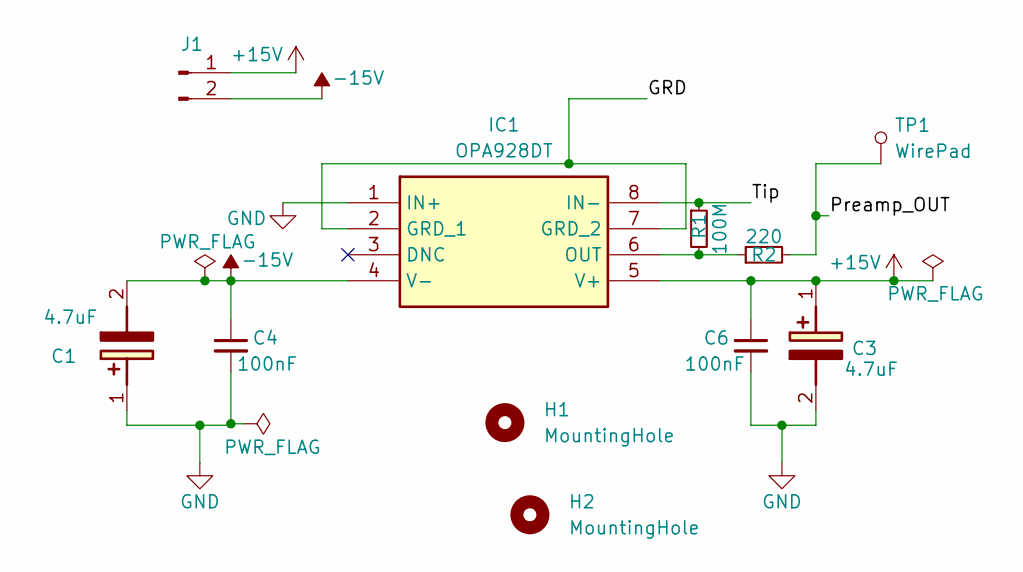
[picture p43: schematic Tunnleing_Amp.kicad_sch]

Parts:
C1, C3: 4.7uF; CAPPM6032X280N; Mouser Part Number 74-293D475X9035C2TE3
C4, C6: 100nF; C_0402_1005Metric; LCSC C1545
H1, H2: MountingHole; MountingHole_2.2mm_M2
IC1: OPA928DT; SOIC127P600X175-8N; Mouser Part Number 595-OPA928DT
J1: Conn_01x02_Pin; PinHeader_1x02_P2.54mm_Vertical
R1: 100M; R_0603_1608Metric; Mouser Part Number 708-HMC0603FT100M; LCSC C22962
R2: 220; R_0603_1608Metric; LCSC C22962
TP1: WirePad; PinHeader_1x01_P1.00mm_Vertical

Connections:
+15V: C3.1 (+), C6.1, IC1.5 (V+), J1.1
-15V: C1.2 (-), C4.1, IC1.4 (V-), J1.2
/GRD: IC1.2 (GRD_1), IC1.7 (GRD_2)
/Preamp_OUT: R2.2, TP1.1
/Tip: IC1.8 (IN-), R1.1
GND: C1.1 (+), C3.2 (-), C4.2, C6.2, IC1.1 (IN+)
unnamed: IC1.6 (OUT), R1.2, R2.1

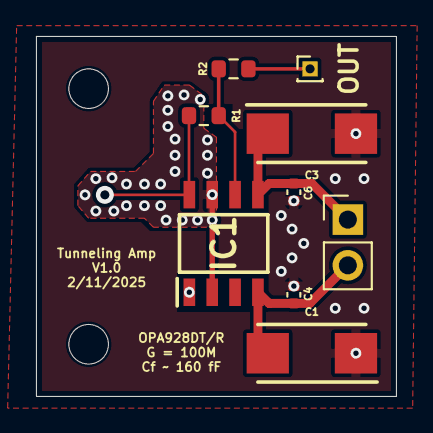
[picture p44: board Tunnleing_Amp.kicad_pcb from above]

Board: 4 copper layers, 20.0 x 20.0 mm, 11 parts (0 on the bottom side), 7 nets.
