annegautham/STM/Power_Supply/Power_Supply.kicad_pcb

## KiCad design Power_Supply/Power_Supply.kicad_pcb (2026-01-07)

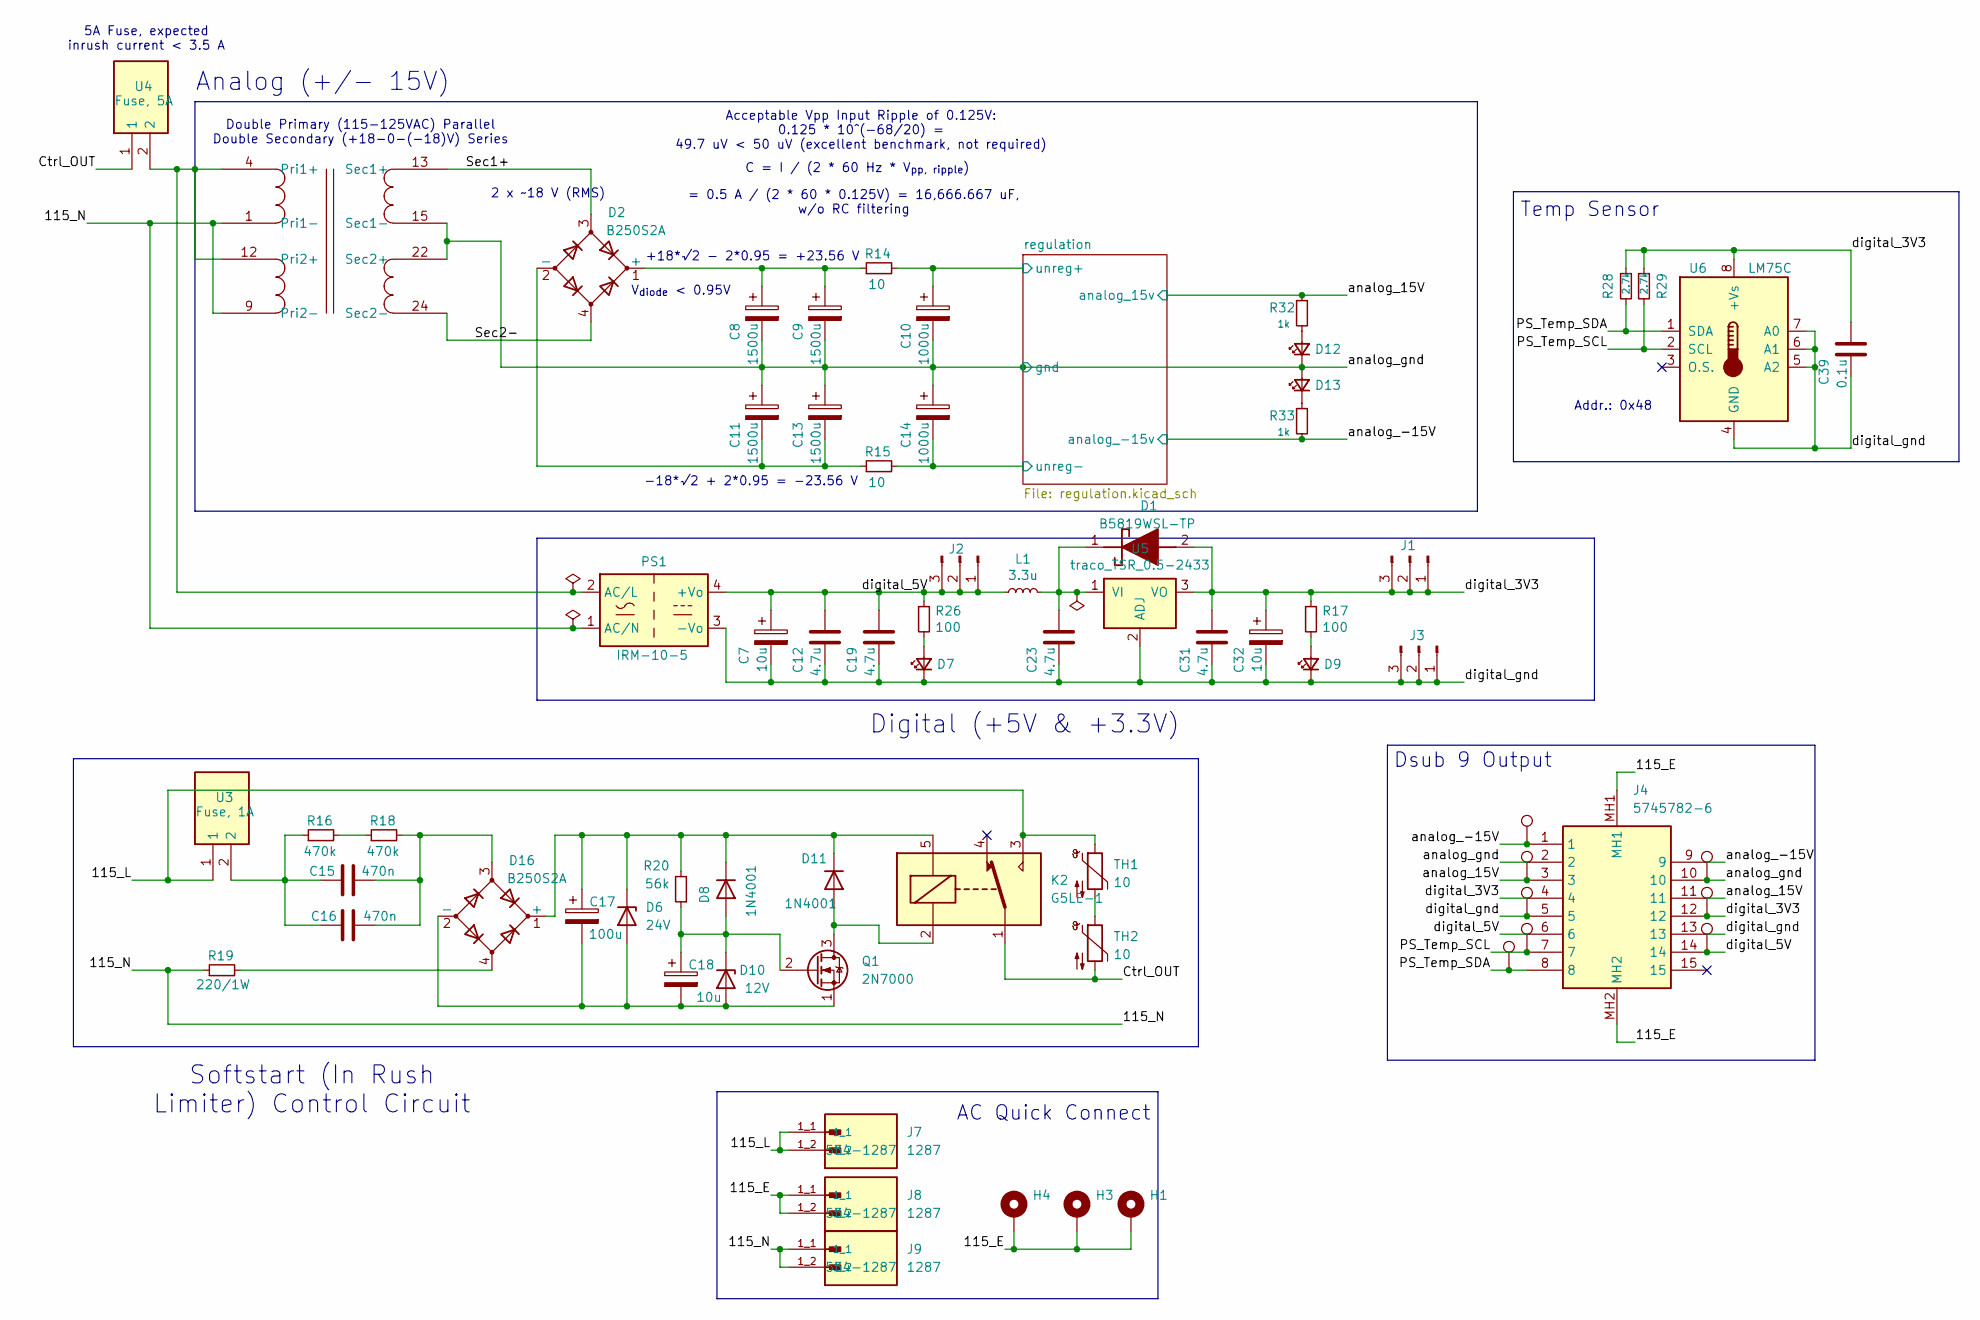
[picture p45: schematic Power_Supply.kicad_sch]

Parts:
C7, C32: 10u; CP_EIA-7343-31_Kemet-D; Mouser Part Number 80-T491D106K025
C8, C9, C11, C13: 1500u; CP_Radial_D12.5mm_P5.00mm_+Better; Mouser Part Number 647-UHW1H152MHD
C10, C14: 1000u; CP_Radial_D12.5mm_P5.00mm_+Better; Mouser Part Number 647-UHW1H102MHD
C12, C19, C23, C31: 4.7u; C_0603_1608Metric; Mouser Part Number 187-CL10A475KO8NQNC
C15, C16: 470n; CAP_R46KN347000N0M_KEM; Mouser Part Number 80-R46KN347000N0M
C17: 100u; C_Radial_D10.0mm_H12.5mm_P5.00mm; Mouser Part Number 594-2222-140-50101
C18: 10u; CP_Radial_D5.0mm_P2.00mm; Mouser Part Number 710-860010372001
C39: 0.1u; C_0603_1608Metric; Mouser Part Number 80-C0603C104J1RAUTO7
D1: B5819WSL-TP; SODFL2512X90N; Mouser Part Number 833-B5819WSL-TP
D2, D16: B250S2A; P20_SO-DIL-Slim; Mouser Part Number 637-B250S2A-SLIM
D6: 24V; D_SOD-123; Mouser Part Number 863-SZMMSZ4709T1G
D7, D9, D12, D13: LED_Small; LED_0603_1608Metric
D8, D11: 1N4001; D_DO-41_SOD81_P10.16mm_Horizontal; Mouser Part Number 637-1N4001
D10: 12V; D_SOD-123; Mouser Part Number 78-MMSZ4699-HE3_A-08
H1, H3, H4: MountingHole_Pad; MountingHole_3.2mm_M3_Pad_Via
J1, J2, J3: Conn_01x03_Pin; PinHeader_1x03_P2.54mm_Vertical
J4: 5745782-6; 57457826; Mouser Part Number 571-5745782-6
J7, J8, J9: 1287; KEYSTONE_1287; PARTREV F; Mouser Part Number 534-1287
K2: G5LE-1; Relay_SPDT_Omron-G5LE-1; Mouser Part Number 653-G5LE-1-SDC24
L1: 3.3u; IND_BOURNS_SRR1280; Mouser Part Number 652-SRR1280-3R3Y
PS1: IRM-10-5; Converter_ACDC_MeanWell_IRM-10-xx_THT; Mouser Part Number 709-IRM10-5
Q1: 2N7000; TO-92_Inline; Mouser Part Number 512-2N7000
R14, R15: 10; R_1206_3216Metric; Mouser Part Number 71-RCC120610R0JNEA
R16, R18: 470k; R_Axial_DIN0207_L6.3mm_D2.5mm_P15.24mm_Horizontal; Mouser Part Number 71-CCF07470KJKE36
R17, R26: 100; R_0805_2012Metric; Mouser Part Number 710-560112120020
R19: 220/1W; R_2512_6332Metric; Mouser Part Number 279-3520220RJT
R20: 56k; R_0805_2012Metric; Mouser Part Number 755-ESR10EZPF5602
R28, R29: 2.7k; R_0805_2012Metric; Mouser Part Number 603-AA0805JR-072K7L
R32, R33: 1k; R_0805_2012Metric
T1: FLN_40_18
TH1, TH2: 10; R_Axial_DIN0204_L3.6mm_D1.6mm_P5.08mm_Horizontal; Mouser Part Number 995-SL10-10002
TP1, TP2, TP3, TP4, TP5, TP6, TP7, TP8: TestPoint; TestPoint_Loop_D1.80mm_Drill1.0mm_Beaded; Mouser Part Number 534-5005
U3: Fuse, 1A; 0PTF0078P; Mouser Part Number 576-0PTF0078P
U4: Fuse, 5A; 0PTF0078P; Mouser Part Number 576-0PTF0078P
U5: traco_TSR_0.5-2433; TSR-0.5-2433; Mouser Part Number 495-TSR0.5-2433
U6: LM75C; SOIC-8_3.9x4.9mm_P1.27mm; Mouser Part Number 700-LM75BIM-3+

Connections:
/115_E: H1.1, H3.1, H4.1, J4.MH1, J4.MH2, J8.1_1, J8.1_2
/115_L: J7.1_1, J7.1_2, K2.3, TH1.1, U3.1
/115_N: J9.1_1, J9.1_2, PS1.1 (AC/N), R19.1, T1.1 (Pri1-), T1.9 (Pri2-)
/Ctrl_OUT: K2.1, TH2.2, U4.1
/PS_Temp_SCL: J4.7, R29.2, TP7.1, U6.2 (SCL)
/PS_Temp_SDA: J4.8, R28.2, TP8.1, U6.1 (SDA)
/Sec1+: D2.3, T1.13 (Sec1+)
/Sec2-: D2.4, T1.24 (Sec2-)
/analog_15V: J4.3, J4.11, R32.1, TP3.1; also elsewhere on the board
/analog_-15V: J4.1, J4.9, R33.2, TP1.1; also elsewhere on the board
/analog_gnd: C8.2, C9.2, C10.2, C11.1, C13.1, C14.1, D12.1 (K), D13.2 (A), J4.2, J4.10, T1.15 (Sec1-), T1.22 (Sec2+), TP2.1; also elsewhere on the board
/digital_3V3: C31.1, C32.1, C39.1, D1.2 (A), J1.1, J1.2, J1.3, J4.4, J4.12, R17.1, R28.1, R29.1, TP4.1, U5.3 (VO), U6.8 (+Vs)
/digital_5V: C7.1, C12.1, C19.1, J2.1, J2.2, J2.3, J4.6, J4.14, L1.1, PS1.4 (+Vo), R26.1, TP6.1
/digital_gnd: C7.2, C12.2, C19.2, C23.2, C31.2, C32.2, C39.2, D7.1 (K), D9.1 (K), J3.1, J3.2, J3.3, J4.5, J4.13, PS1.3 (-Vo), TP5.1, U5.2 (ADJ), U6.4 (GND), U6.5 (A2), U6.6 (A1), U6.7 (A0)
/regulation/unreg+: C10.1, R14.2; also elsewhere on the board
/regulation/unreg-: C14.2, R15.2; also elsewhere on the board
unnamed: C15.1, C16.1, R16.1, U3.2
unnamed: C15.2, C16.2, D16.3, R18.2
unnamed: C23.1, D1.1 (K), L1.2, U5.1 (VI)
unnamed: C8.1, C9.1, D2.1 (+), R14.1
unnamed: C11.2, C13.2, D2.2 (-), R15.1
unnamed: D7.2 (A), R26.2
unnamed: D9.2 (A), R17.2
unnamed: C17.2, C18.2, D6.2 (A), D10.2 (A), D16.2 (-), Q1.1 (S)
unnamed: C18.1, D8.2 (A), D10.1 (K), Q1.2 (G), R20.1
unnamed: D11.2 (A), K2.2, Q1.3 (D)
unnamed: C17.1, D6.1 (K), D8.1 (K), D11.1 (K), D16.1 (+), K2.5, R20.2
unnamed: D12.2 (A), R32.2
unnamed: D13.1 (K), R33.1
unnamed: D16.4, R19.2
unnamed: PS1.2 (AC/L), T1.4 (Pri1+), T1.12 (Pri2+), U4.2
unnamed: R16.2, R18.1
unnamed: TH1.2, TH2.1

Notes on the sheet:
Dsub 9 Output
Addr.: 0x48
Analog (+/- 15V)
5A Fuse, expected inrush current < 3.5 A
Acceptable Vpp Input Ripple of 0.125V: 0.125 * 10^(-68/20) = 49.7 uV < 50 uV (excellent benchmark, not required)
Double Primary (115-125VAC) Parallel Double Secondary (+18-0-(-18)V) Series
Softstart (In Rush Limiter) Control Circuit
-18*√2 + 2*0.95 = -23.56 V
C = I / (2 * 60 Hz * V_{pp, ripple})
V_{diode} < 0.95V
AC Quick Connect
2 x ~18 V (RMS)
Temp Sensor
+18*√2 - 2*0.95 = +23.56 V
Digital (+5V & +3.3V)
= 0.5 A / (2 * 60 * 0.125V) = 16,666.667 uF, w/o RC filtering

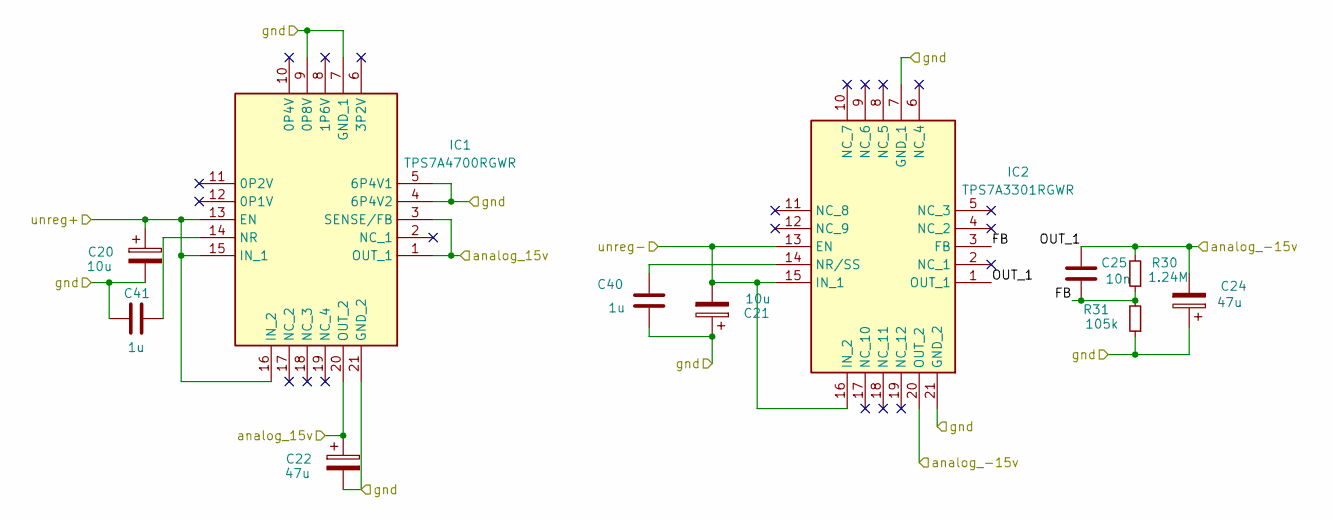
[picture p46: schematic regulation.kicad_sch]

Parts:
C20, C21: 10u; CP_EIA-7343-31_Kemet-D; Mouser Part Number 80-T491D106K025
C22, C24: 47u; CP_EIA-7343-31_Kemet-D; Mouser Part Number 80-T491D476K020
C25: 10n; C_0603_1608Metric; Mouser Part Number 581-06033C103KAZ2A
C40, C41: 1u; C_0603_1608Metric; Mouser Part Number 963-MLASU168SB5105KT
IC1: TPS7A4700RGWR; QFN65P500X500X100-21N-D; Mouser Part Number 595-TPS7A4700RGWR
IC2: TPS7A3301RGWR; QFN65P500X500X100-21N-D; Mouser Part Number 595-TPS7A3301RGWR
R30: 1.24M; R_0805_2012Metric; Mouser Part Number 71-CRCW08051M24FKEA
R31: 105k; R_0805_2012Metric; Mouser Part Number 279-RQ73C2A105KBTD

Connections:
/analog_15V: C22.1, IC1.1 (OUT_1), IC1.3 (SENSE/FB), IC1.20 (OUT_2); also elsewhere on the board
/analog_-15V: C24.2, C25.1, IC2.1 (OUT_1), IC2.20 (OUT_2), R30.2; also elsewhere on the board
/analog_gnd: C20.2, C21.1, C22.2, C24.1, C40.2, C41.2, IC1.4 (6P4V2), IC1.5 (6P4V1), IC1.7 (GND_1), IC1.9 (0P8V), IC1.21 (GND_2), IC2.7 (GND_1), IC2.21 (GND_2), R31.1; also elsewhere on the board
/regulation/FB: C25.2, IC2.3 (FB), R30.1, R31.2
/regulation/unreg+: C20.1, IC1.13 (EN), IC1.15 (IN_1), IC1.16 (IN_2); also elsewhere on the board
/regulation/unreg-: C21.2, IC2.13 (EN), IC2.15 (IN_1), IC2.16 (IN_2); also elsewhere on the board
unnamed: C41.1, IC1.14 (NR)
unnamed: C40.1, IC2.14 (NR/SS)

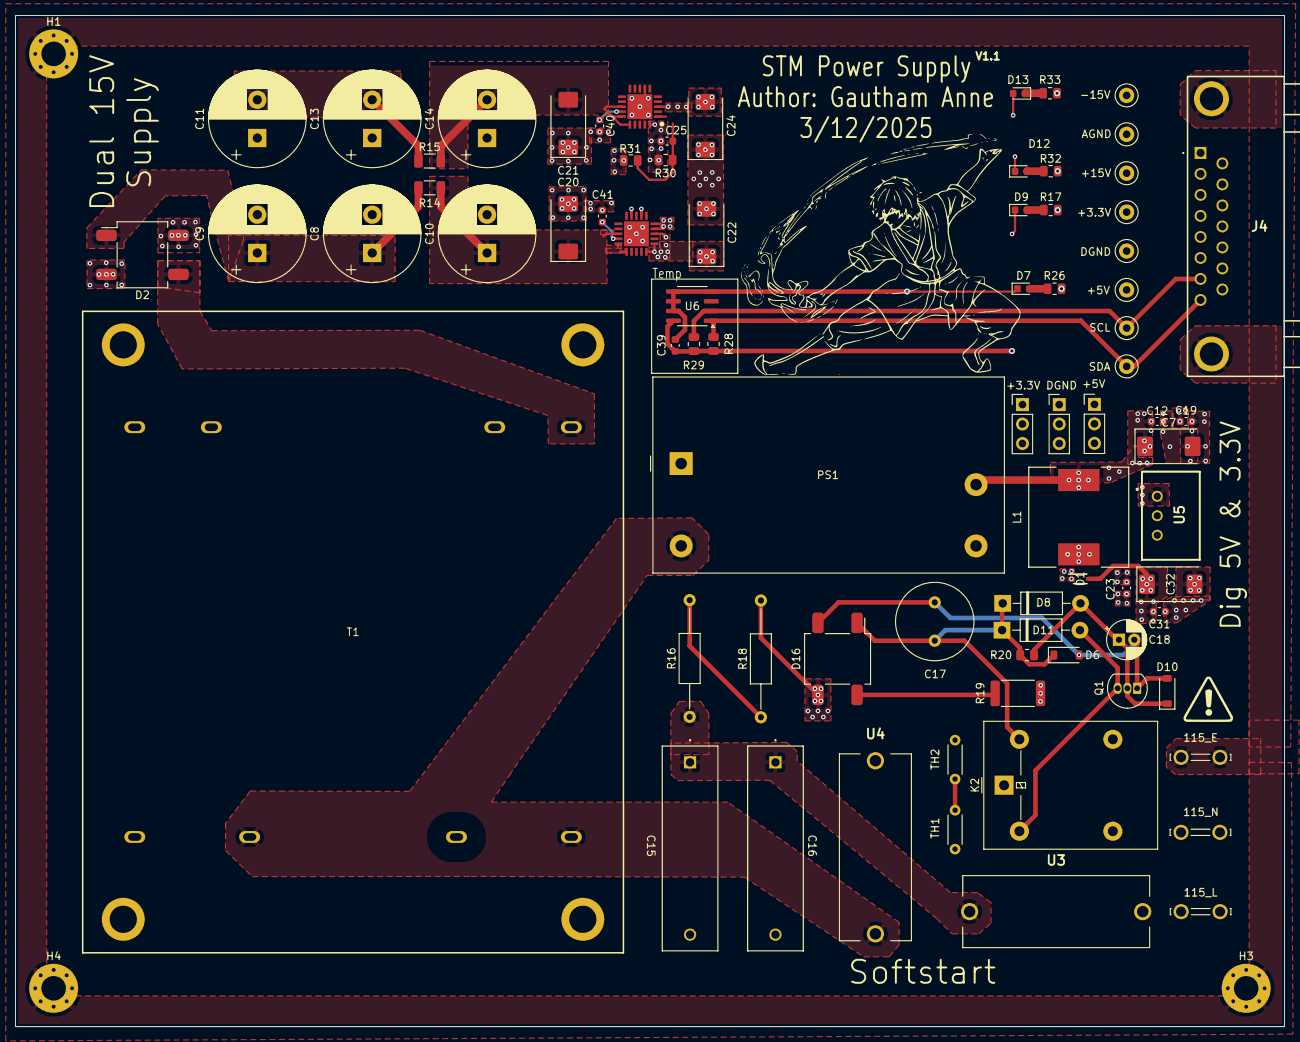
[picture p47: board Power_Supply.kicad_pcb from above]

Board: 4 copper layers, 165.7 x 132.0 mm, 80 parts (0 on the bottom side), 36 nets.
