annegautham/STM/Mainboard/Mainboard.kicad_pcb

## KiCad design Mainboard/Mainboard.kicad_pcb (2025-11-16)

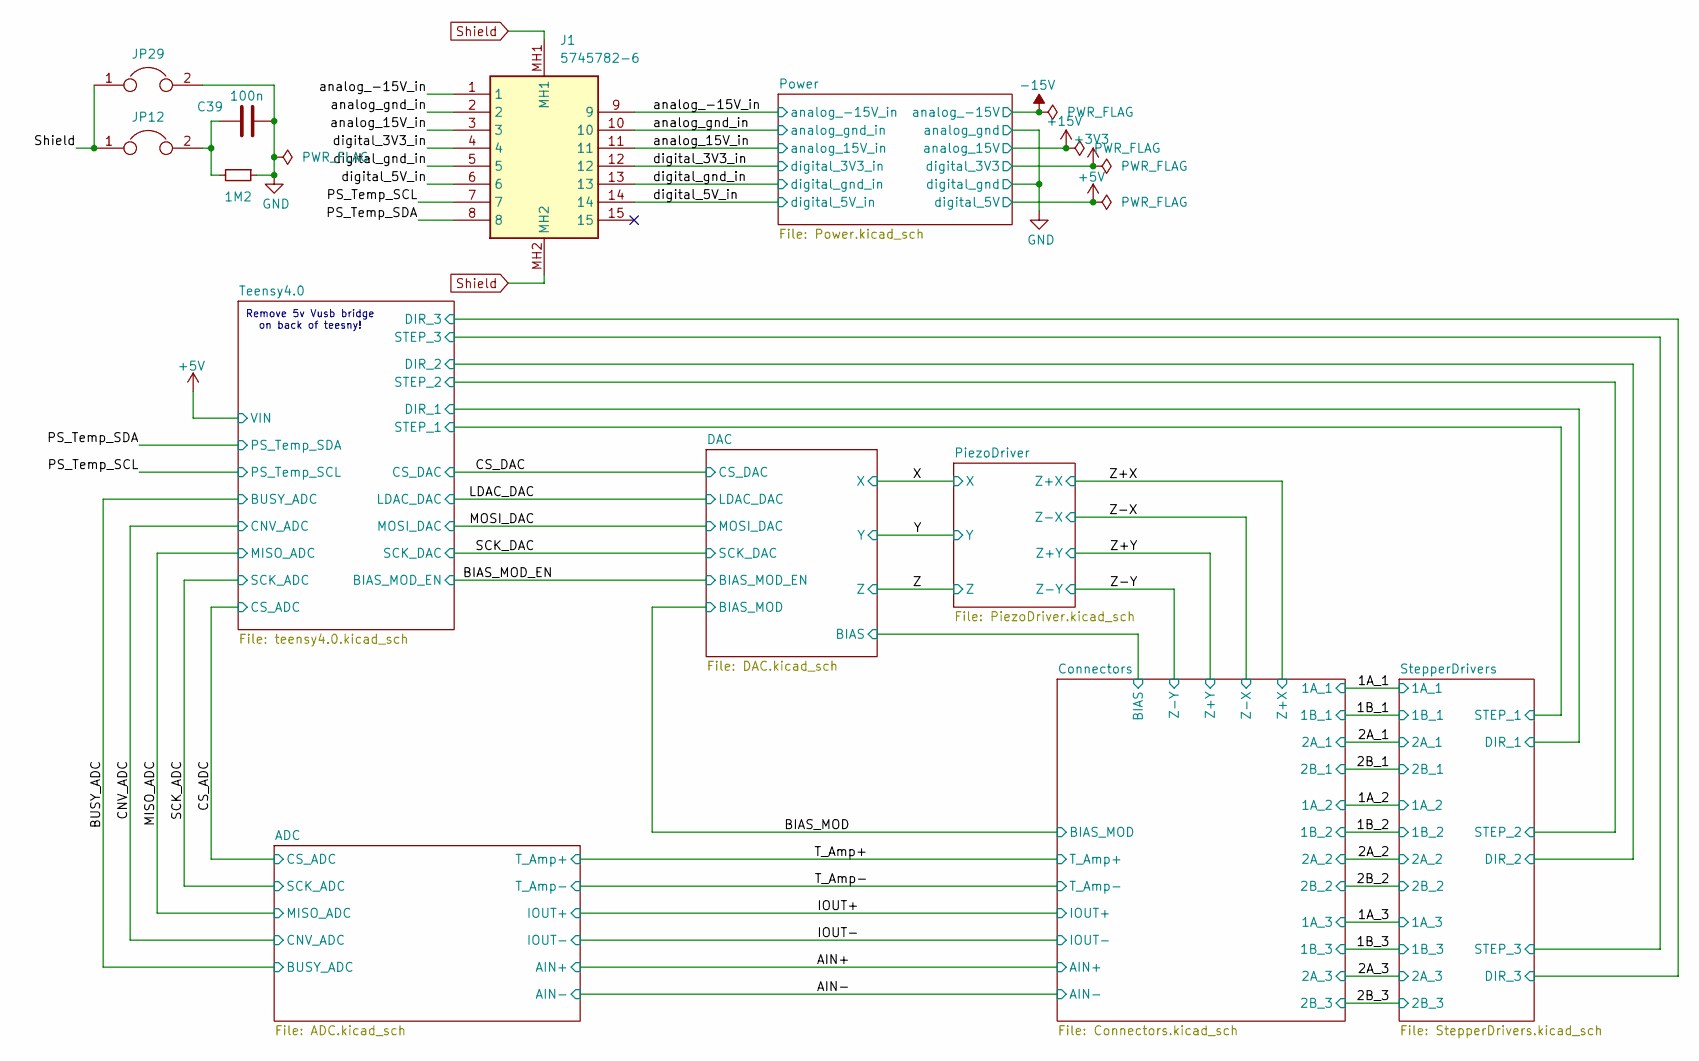
[picture p48: schematic Mainboard.kicad_sch]

Parts:
C39: 100n; C_0805_2012Metric; Mouser Part Number 80-C0805S104K1RACAUT; LCSC C14663
J1: 5745782-6; 57457826; Mouser Part Number 571-5745782-6
JP12, JP29: Jumper; SolderJumper-2_P1.3mm_Open_TrianglePad1.0x1.5mm
R30: 1M2; R_0805_2012Metric; Mouser Part Number 755-SDR10EZPF1204; LCSC C22107

Connections:
+3V3: J1.4, J1.12; also elsewhere on the board
+5V: J1.6, J1.14; also elsewhere on the board
+15V: J1.3, J1.11; also elsewhere on the board
-15V: J1.1, J1.9; also elsewhere on the board
/PS_Temp_SCL: J1.7; also elsewhere on the board
/PS_Temp_SDA: J1.8; also elsewhere on the board
GND: C39.2, J1.2, J1.5, J1.10, J1.13, JP29.2, R30.1; also elsewhere on the board
unnamed: C39.1, JP12.2, R30.2
Shield: J1.MH1, J1.MH2, JP12.1, JP29.1; also elsewhere on the board

Notes on the sheet:
Remove 5v Vusb bridge on back of teesny!

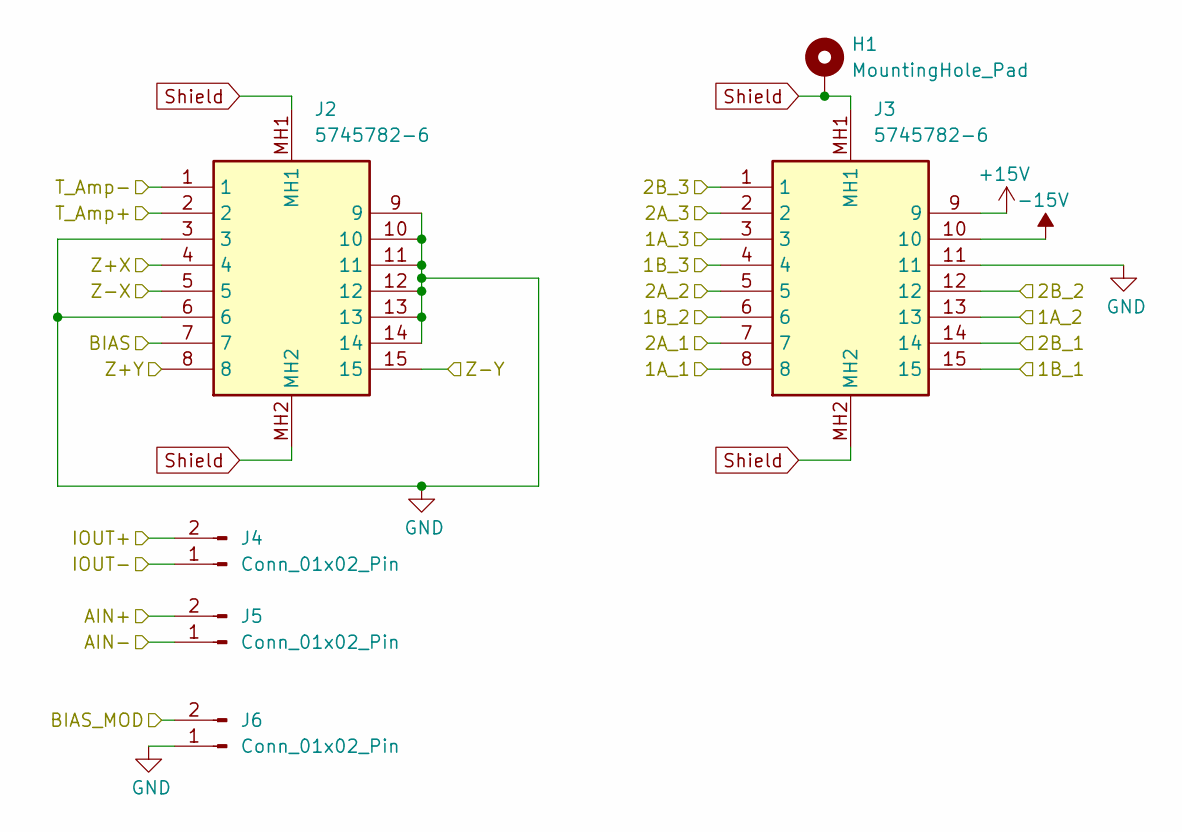
[picture p49: schematic Connectors.kicad_sch]

Parts:
H1: MountingHole_Pad; MountingHole_2.2mm_M2_Pad_Via
J2, J3: 5745782-6; 57457826; Mouser Part Number 571-5745782-6
J4, J5, J6: Conn_01x02_Pin; PinHeader_1x02_P2.54mm_Vertical

Connections:
+15V: J3.9; also elsewhere on the board
-15V: J3.10; also elsewhere on the board
/1A_1: J3.8; also elsewhere on the board
/1A_2: J3.13; also elsewhere on the board
/1A_3: J3.3; also elsewhere on the board
/1B_1: J3.15; also elsewhere on the board
/1B_2: J3.6; also elsewhere on the board
/1B_3: J3.4; also elsewhere on the board
/2A_1: J3.7; also elsewhere on the board
/2A_2: J3.5; also elsewhere on the board
/2A_3: J3.2; also elsewhere on the board
/2B_1: J3.14; also elsewhere on the board
/2B_2: J3.12; also elsewhere on the board
/2B_3: J3.1; also elsewhere on the board
/AIN+: J5.2; also elsewhere on the board
/AIN-: J5.1; also elsewhere on the board
/BIAS_MOD: J6.2; also elsewhere on the board
/Connectors/BIAS: J2.7; also elsewhere on the board
/IOUT+: J4.2; also elsewhere on the board
/IOUT-: J4.1; also elsewhere on the board
/T_Amp+: J2.2; also elsewhere on the board
/T_Amp-: J2.1; also elsewhere on the board
/Z+X: J2.4; also elsewhere on the board
/Z+Y: J2.8; also elsewhere on the board
/Z-X: J2.5; also elsewhere on the board
/Z-Y: J2.15; also elsewhere on the board
GND: J2.3, J2.6, J2.9, J2.10, J2.11, J2.12, J2.13, J2.14, J3.11, J6.1; also elsewhere on the board
Shield: H1.1, J2.MH1, J2.MH2, J3.MH1, J3.MH2; also elsewhere on the board

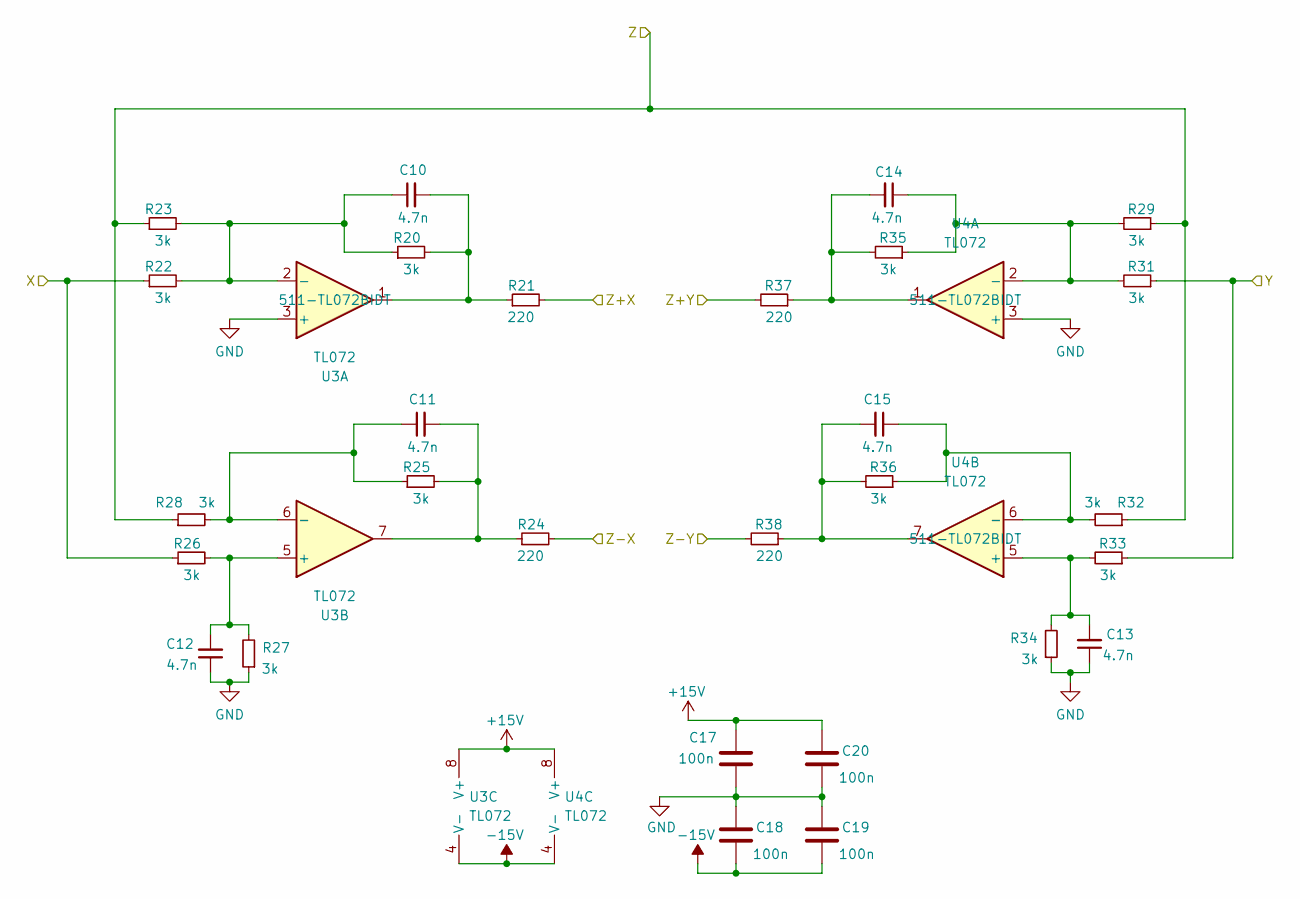
[picture p50: schematic PiezoDriver.kicad_sch]

Parts:
C10, C11, C12, C13, C14, C15: 4.7n; C_0805_2012Metric; Mouser Part Number 80-C0805C472J3GAUTO
C17, C18, C19, C20: 100n; C_0805_2012Metric; Mouser Part Number 80-C0805S104K1RACAUT; LCSC C14663
R20, R22, R23, R25, R26, R27, R28, R29, R31, R32, R33, R34, R35, R36: 3k; R_0805_2012Metric; Mouser Part Number 667-ERA-6AED302V
R21, R24, R37, R38: 220; R_0805_2012Metric; Mouser Part Number 279-CRGH0805F220R
U3, U4: TL072; SOIC-8-1EP_3.9x4.9mm_P1.27mm_EP2.29x3mm_ThermalVias; Mouser Part Number 511-TL072BIDT

Connections:
+15V: C17.1, C20.1, U3.8 (V+), U4.8 (V+); also elsewhere on the board
-15V: C18.2, C19.2, U3.4 (V-), U4.4 (V-); also elsewhere on the board
/X: R22.1, R26.1; also elsewhere on the board
/Y: R31.1, R33.1; also elsewhere on the board
/Z: R23.1, R28.1, R29.1, R32.1; also elsewhere on the board
/Z+X: R21.2; also elsewhere on the board
/Z+Y: R37.2; also elsewhere on the board
/Z-X: R24.2; also elsewhere on the board
/Z-Y: R38.2; also elsewhere on the board
GND: C12.1, C13.1, C17.2, C18.1, C19.1, C20.2, R27.1, R34.1, U3.3 (+), U4.3 (+); also elsewhere on the board
unnamed: C10.2, R20.2, R21.1, U3.1
unnamed: C11.2, R24.1, R25.2, U3.7
unnamed: C14.2, R35.2, R37.1, U4.1
unnamed: C15.2, R36.2, R38.1, U4.7
unnamed: C10.1, R20.1, R22.2, R23.2, U3.2 (-)
unnamed: C12.2, R26.2, R27.2, U3.5 (+)
unnamed: C11.1, R25.1, R28.2, U3.6 (-)
unnamed: C14.1, R29.2, R31.2, R35.1, U4.2 (-)
unnamed: C13.2, R33.2, R34.2, U4.5 (+)
unnamed: C15.1, R32.2, R36.1, U4.6 (-)

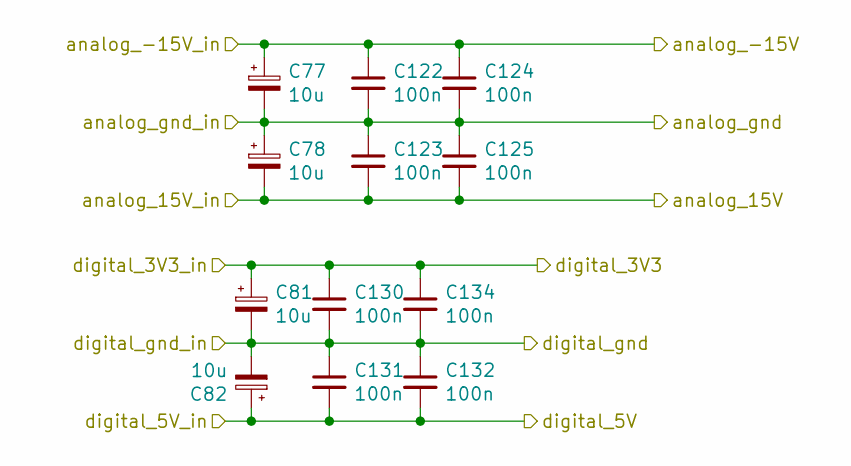
[picture p51: schematic Power.kicad_sch]

Parts:
C77, C78, C81, C82: 10u; CP_Radial_D5.0mm_P2.00mm; Mouser Part Number 710-860020472003
C122, C123, C124, C125, C130, C131, C132, C134: 100n; C_0805_2012Metric; Mouser Part Number 80-C0805S104K1RACAUT

Connections:
+3V3: C81.1, C130.1, C134.1; also elsewhere on the board
+5V: C82.1, C131.2, C132.2; also elsewhere on the board
+15V: C78.2, C123.2, C125.2; also elsewhere on the board
-15V: C77.1, C122.1, C124.1; also elsewhere on the board
GND: C77.2, C78.1, C81.2, C82.2, C122.2, C123.1, C124.2, C125.1, C130.2, C131.1, C132.1, C134.2; also elsewhere on the board

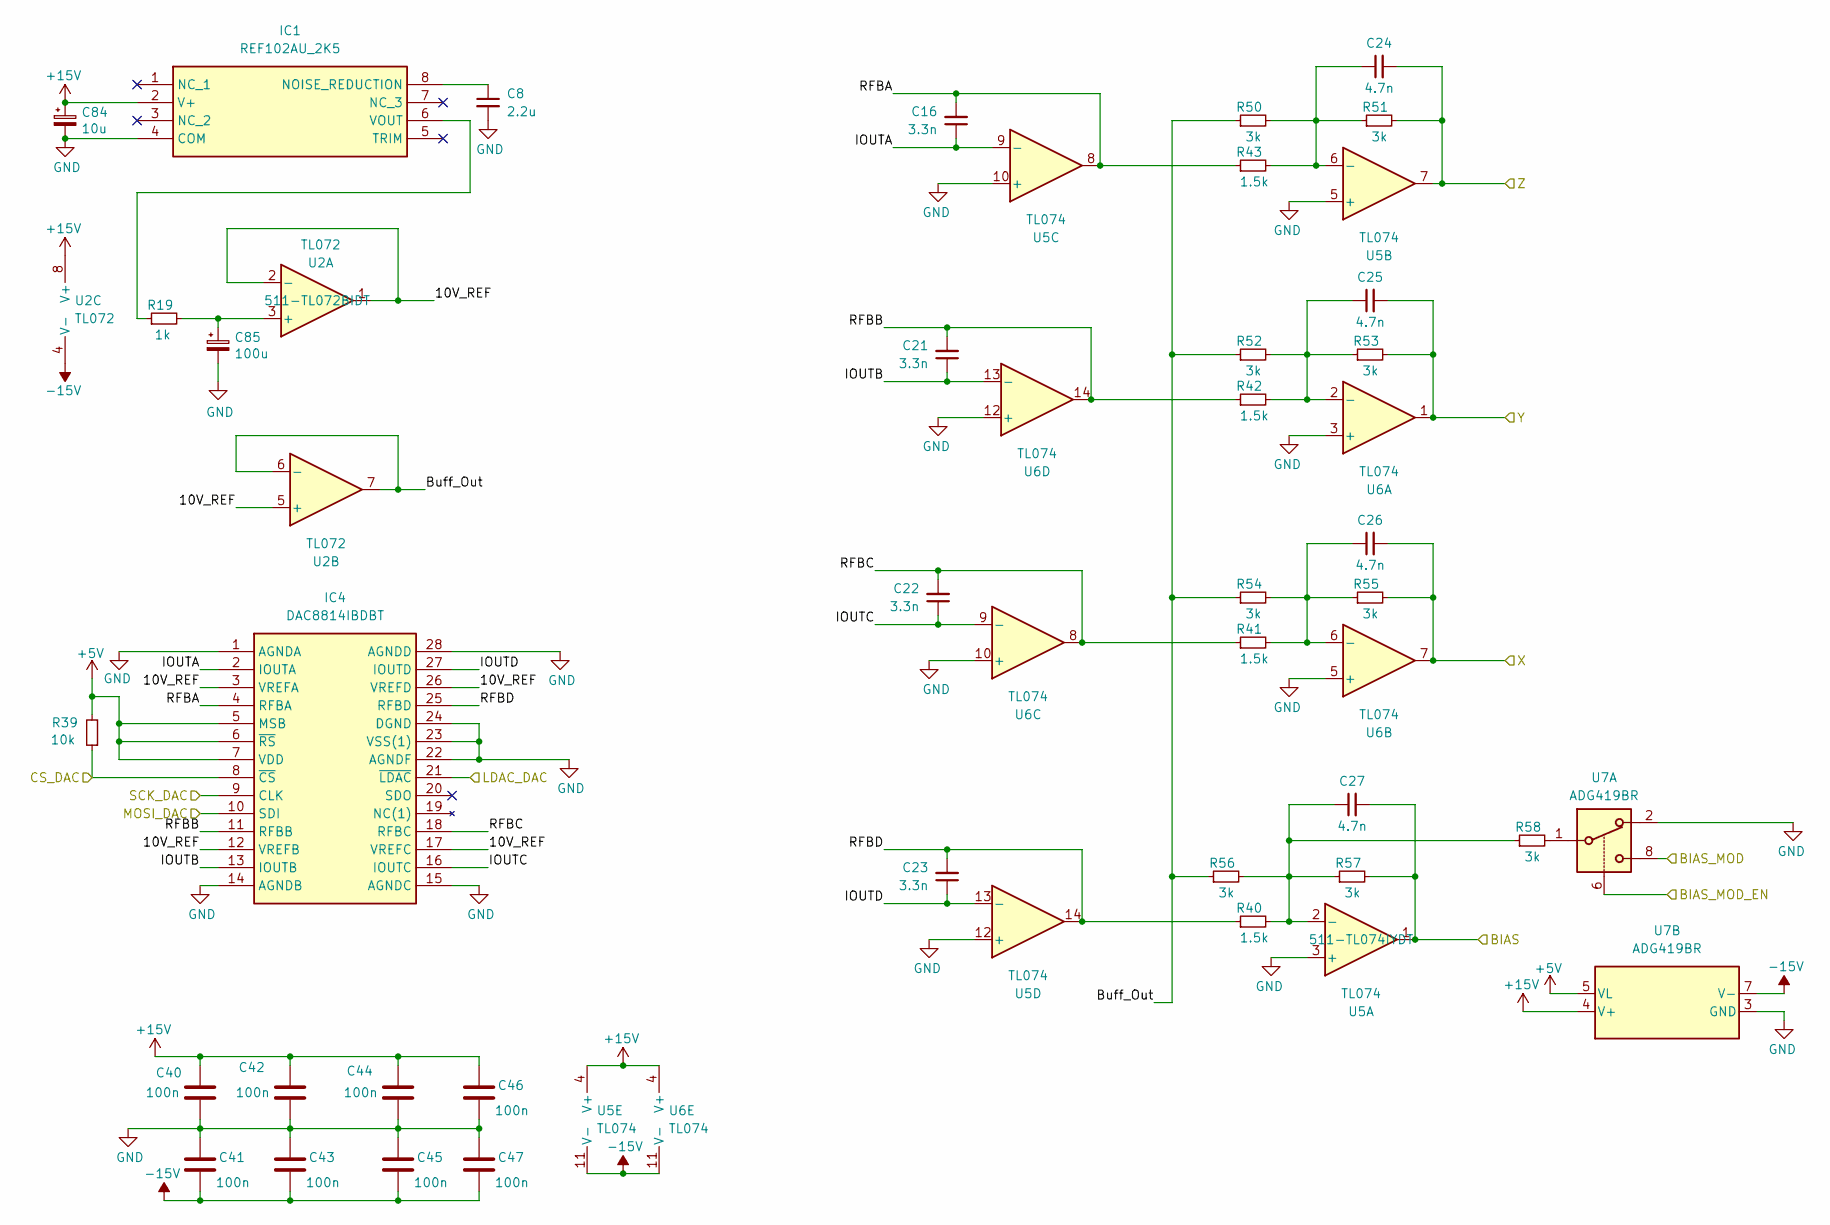
[picture p52: schematic DAC.kicad_sch]

Parts:
C8: 2.2u; C_0805_2012Metric; Mouser Part Number 80-C0805C225K4R3123
C16, C21, C22, C23: 3.3n; C_0805_2012Metric; Mouser Part Number 80-C0805C332KCR
C24, C25, C26, C27: 4.7n; C_0805_2012Metric; Mouser Part Number 80-C0805C472J3GAUTO
C40, C41, C42, C43, C44, C45, C46, C47: 100n; C_0805_2012Metric; Mouser Part Number 80-C0805S104K1RACAUT; LCSC C14663
C84: 10u; CP_Radial_D5.0mm_P2.00mm; Mouser Part Number 710-860020472003
C85: 100u; CP_Radial_D6.3mm_P2.50mm; Mouser Part Number 80-ESW107M016AE3EA
IC1: REF102AU_2K5; SOIC127P600X175-8N; Mouser Part Number 595-REF102AU/2K5
IC4: DAC8814IBDBT; SOP65P780X200-28N; Mouser Part Number 595-DAC8814IBDBT
R19: 1k; R_0805_2012Metric; Mouser Part Number 755-ESR10EZPJ102
R39: 10k; R_0805_2012Metric; Mouser Part Number 755-ESR10EZPD1002
R40, R41, R42, R43: 1.5k; R_0805_2012Metric; Mouser Part Number 755-ESR10EZPF1501
R50, R51, R52, R53, R54, R55, R56, R57, R58: 3k; R_0805_2012Metric; Mouser Part Number 667-ERA-6AED302V
U2: TL072; SOIC-8-1EP_3.9x4.9mm_P1.27mm_EP2.29x3mm_ThermalVias; Mouser Part Number 511-TL072BIDT
U5, U6: TL074; SOIC-14_3.9x8.7mm_P1.27mm; Mouser Part Number 511-TL074IYDT
U7: ADG419BR; SOIC-8_3.9x4.9mm_P1.27mm; Mouser Part Number 584-ADG419BRZ-R

Connections:
+5V: IC4.5 (MSB), IC4.6 (~RS), IC4.7 (VDD), R39.2, U7.5 (VL); also elsewhere on the board
+15V: C40.1, C42.1, C44.1, C46.1, C84.1, IC1.2 (V+), U2.8 (V+), U5.4 (V+), U6.4 (V+), U7.4 (V+); also elsewhere on the board
-15V: C41.2, C43.2, C45.2, C47.2, U2.4 (V-), U5.11 (V-), U6.11 (V-), U7.7 (V-); also elsewhere on the board
/BIAS_MOD: U7.8; also elsewhere on the board
/BIAS_MOD_EN: U7.6; also elsewhere on the board
/CS_DAC: IC4.8 (~CS), R39.1; also elsewhere on the board
/Connectors/BIAS: C27.2, R57.2, U5.1; also elsewhere on the board
/DAC/10V_REF: IC4.3 (VREFA), IC4.12 (VREFB), IC4.17 (VREFC), IC4.26 (VREFD), U2.1, U2.2 (-), U2.5 (+)
/DAC/Buff_Out: R50.1, R52.1, R54.1, R56.1, U2.6 (-), U2.7
/DAC/IOUTA: C16.1, IC4.2 (IOUTA), U5.9 (-)
/DAC/IOUTB: C21.1, IC4.13 (IOUTB), U6.13 (-)
/DAC/IOUTC: C22.1, IC4.16 (IOUTC), U6.9 (-)
/DAC/IOUTD: C23.1, IC4.27 (IOUTD), U5.13 (-)
/DAC/RFBA: C16.2, IC4.4 (RFBA), R43.1, U5.8
/DAC/RFBB: C21.2, IC4.11 (RFBB), R42.1, U6.14
/DAC/RFBC: C22.2, IC4.18 (RFBC), R41.1, U6.8
/DAC/RFBD: C23.2, IC4.25 (RFBD), R40.1, U5.14
/LDAC_DAC: IC4.21 (~LDAC); also elsewhere on the board
/MOSI_DAC: IC4.10 (SDI); also elsewhere on the board
/SCK_ADC: IC4.9 (CLK); also elsewhere on the board
/X: C26.2, R55.2, U6.7; also elsewhere on the board
/Y: C25.2, R53.2, U6.1; also elsewhere on the board
/Z: C24.2, R51.2, U5.7; also elsewhere on the board
GND: C8.2, C40.2, C41.1, C42.2, C43.1, C44.2, C45.1, C46.2, C47.1, C84.2, C85.2, IC1.4 (COM), IC4.1 (AGNDA), IC4.14 (AGNDB), IC4.15 (AGNDC), IC4.22 (AGNDF), IC4.23 (VSS(1)), IC4.24 (DGND), IC4.28 (AGNDD), U5.3 (+), U5.5 (+), U5.10 (+), U5.12 (+), U6.3 (+), U6.5 (+), U6.10 (+), U6.12 (+), U7.2, U7.3 (GND); also elsewhere on the board
unnamed: C8.1, IC1.8 (NOISE_REDUCTION)
unnamed: IC1.6 (VOUT), R19.1
unnamed: R58.2, U7.1
unnamed: C85.1, R19.2, U2.3 (+)
unnamed: C27.1, R40.2, R56.2, R57.1, R58.1, U5.2 (-)
unnamed: C24.1, R43.2, R50.2, R51.1, U5.6 (-)
unnamed: C25.1, R42.2, R52.2, R53.1, U6.2 (-)
unnamed: C26.1, R41.2, R54.2, R55.1, U6.6 (-)

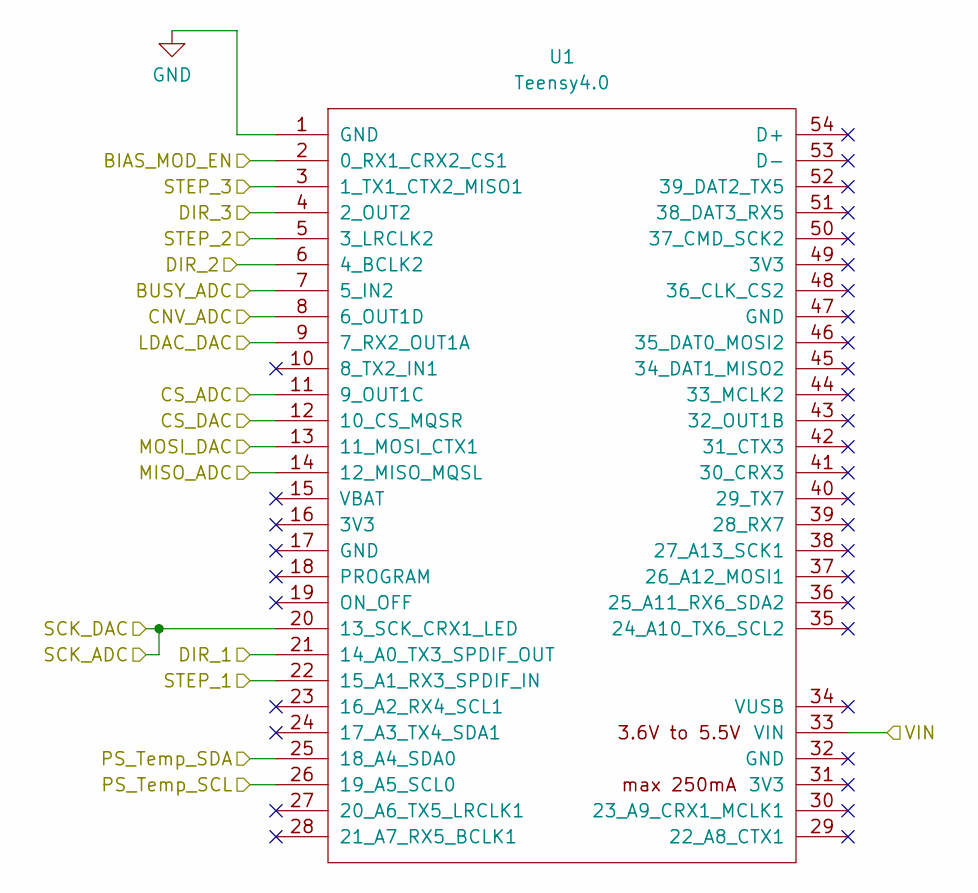
[picture p53: schematic teensy4.0.kicad_sch]

Parts:
U1: Teensy4.0; Teensy40

Connections:
+5V: U1.33 (VIN); also elsewhere on the board
/BIAS_MOD_EN: U1.2 (0_RX1_CRX2_CS1); also elsewhere on the board
/BUSY_ADC: U1.7 (5_IN2); also elsewhere on the board
/CNV_ADC: U1.8 (6_OUT1D); also elsewhere on the board
/CS_ADC: U1.11 (9_OUT1C); also elsewhere on the board
/CS_DAC: U1.12 (10_CS_MQSR); also elsewhere on the board
/LDAC_DAC: U1.9 (7_RX2_OUT1A); also elsewhere on the board
/MISO_ADC: U1.14 (12_MISO_MQSL); also elsewhere on the board
/MOSI_DAC: U1.13 (11_MOSI_CTX1); also elsewhere on the board
/PS_Temp_SCL: U1.26 (19_A5_SCL0); also elsewhere on the board
/PS_Temp_SDA: U1.25 (18_A4_SDA0); also elsewhere on the board
/SCK_ADC: U1.20 (13_SCK_CRX1_LED); also elsewhere on the board
/StepperDrivers/DIR_1: U1.21 (14_A0_TX3_SPDIF_OUT); also elsewhere on the board
/StepperDrivers/DIR_2: U1.6 (4_BCLK2); also elsewhere on the board
/StepperDrivers/DIR_3: U1.4 (2_OUT2); also elsewhere on the board
/StepperDrivers/STEP_1: U1.22 (15_A1_RX3_SPDIF_IN); also elsewhere on the board
/StepperDrivers/STEP_2: U1.5 (3_LRCLK2); also elsewhere on the board
/StepperDrivers/STEP_3: U1.3 (1_TX1_CTX2_MISO1); also elsewhere on the board
GND: U1.1 (GND); also elsewhere on the board
