annegautham/STM/Mainboard/Mainboard.kicad_pcb

## KiCad design Mainboard/Mainboard.kicad_pcb (continued)

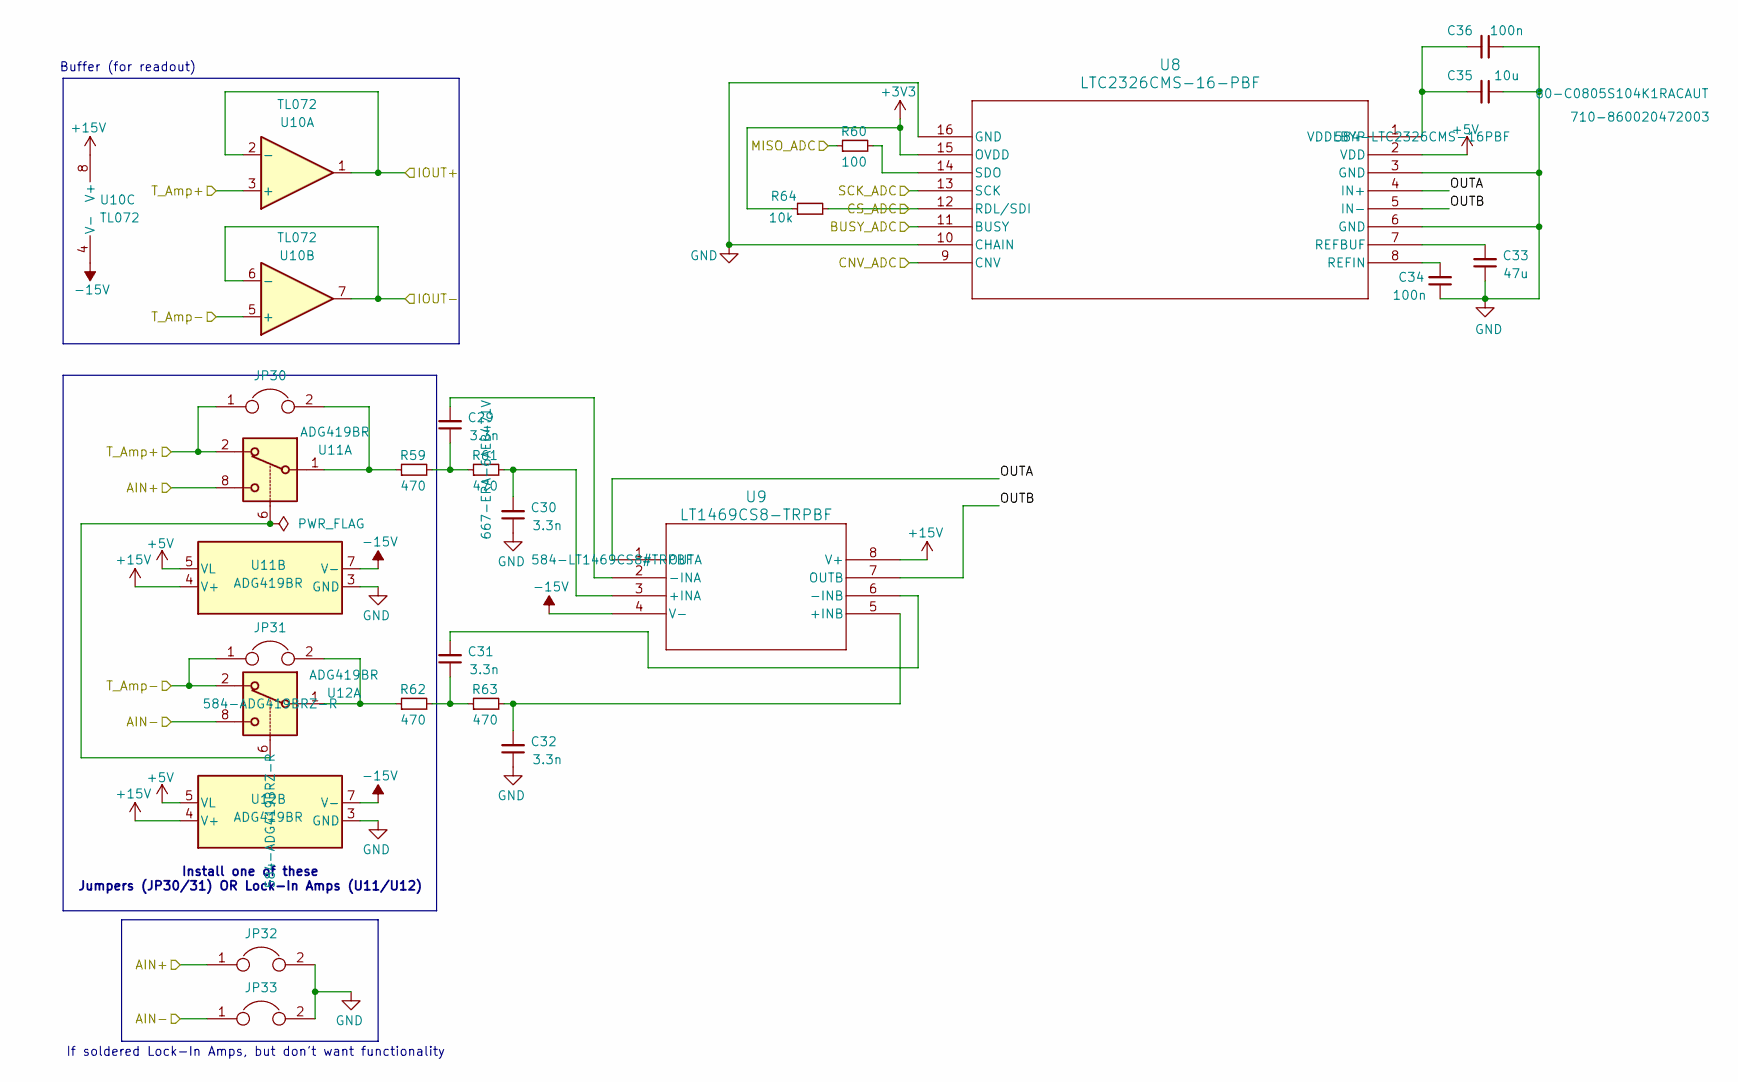
[picture p54: schematic ADC.kicad_sch]

Parts:
C29, C30, C31, C32: 3.3n; C_0805_2012Metric; Mouser Part Number 80-C0805C332KCR
C33: 47u; C_0805_2012Metric; Mouser Part Number 80-C0805C476M9P7800
C34, C36: 100n; C_0805_2012Metric; Mouser Part Number 80-C0805S104K1RACAUT
C35: 10u; CP_Radial_D5.0mm_P2.00mm; Mouser Part Number 710-860020472003
JP30, JP31, JP32, JP33: Jumper; SolderJumper-2_P1.3mm_Open_TrianglePad1.0x1.5mm
R59, R61, R62, R63: 470; R_0805_2012Metric; Mouser Part Number 667-ERA-6AEB471V
R60: 100; R_0805_2012Metric; Mouser Part Number 708-RNCA0805BTE100R
R64: 10k; R_0805_2012Metric; Mouser Part Number 755-ESR10EZPD1002
U8: LTC2326CMS-16-PBF; MSOP-16_MS_LIT; Mouser Part Number 584-LTC2326CMS-16PBF
U9: LT1469CS8-TRPBF; SO-8_S_LIT; Mouser Part Number 584-LT1469CS8#TRPBF
U10: TL072; SOIC-8-1EP_3.9x4.9mm_P1.27mm_EP2.29x3mm_ThermalVias; Mouser Part Number 511-TL072BIDT
U11, U12: ADG419BR; SOIC-8_3.9x4.9mm_P1.27mm; Mouser Part Number 584-ADG419BRZ-R

Connections:
+3V3: R64.1, U8.15 (OVDD); also elsewhere on the board
+5V: U8.2 (VDD), U11.5 (VL), U12.5 (VL); also elsewhere on the board
+15V: U9.8 (V+), U10.8 (V+), U11.4 (V+), U12.4 (V+); also elsewhere on the board
-15V: U9.4 (V-), U10.4 (V-), U11.7 (V-), U12.7 (V-); also elsewhere on the board
/ADC/OUTA: U8.4 (IN+), U9.1 (OUTA)
/ADC/OUTB: U8.5 (IN-), U9.7 (OUTB)
/AIN+: JP32.1, U11.8; also elsewhere on the board
/AIN-: JP33.1, U12.8; also elsewhere on the board
/BUSY_ADC: U8.11 (BUSY); also elsewhere on the board
/CNV_ADC: U8.9 (CNV); also elsewhere on the board
/CS_ADC: R64.2, U8.12 (RDL/SDI); also elsewhere on the board
/IOUT+: U10.1, U10.2 (-); also elsewhere on the board
/IOUT-: U10.6 (-), U10.7; also elsewhere on the board
/MISO_ADC: R60.1; also elsewhere on the board
/SCK_ADC: U8.13 (SCK); also elsewhere on the board
/T_Amp+: JP30.1, U10.3 (+), U11.2; also elsewhere on the board
/T_Amp-: JP31.1, U10.5 (+), U12.2; also elsewhere on the board
GND: C30.1, C32.1, C33.1, C34.1, C35.1, C36.1, JP32.2, JP33.2, U8.3 (GND), U8.6 (GND), U8.10 (CHAIN), U8.16 (GND), U11.3 (GND), U12.3 (GND); also elsewhere on the board
unnamed: C29.1, R59.2, R61.1
unnamed: C31.1, R62.2, R63.1
unnamed: JP30.2, R59.1, U11.1
unnamed: JP31.2, R62.1, U12.1
unnamed: C33.2, U8.7 (REFBUF)
unnamed: C34.2, U8.8 (REFIN)
unnamed: R60.2, U8.14 (SDO)
unnamed: C35.2, C36.2, U8.1 (VDDLBYP)
unnamed: C30.2, R61.2, U9.3 (+INA)
unnamed: C32.2, R63.2, U9.5 (+INB)
unnamed: C29.2, U9.2 (-INA)
unnamed: C31.2, U9.6 (-INB)
unnamed: U11.6, U12.6

Notes on the sheet:
Install one of these Jumpers (JP30/31) OR Lock-In Amps (U11/U12)
If soldered Lock-In Amps, but don't want functionality
Buffer (for readout)

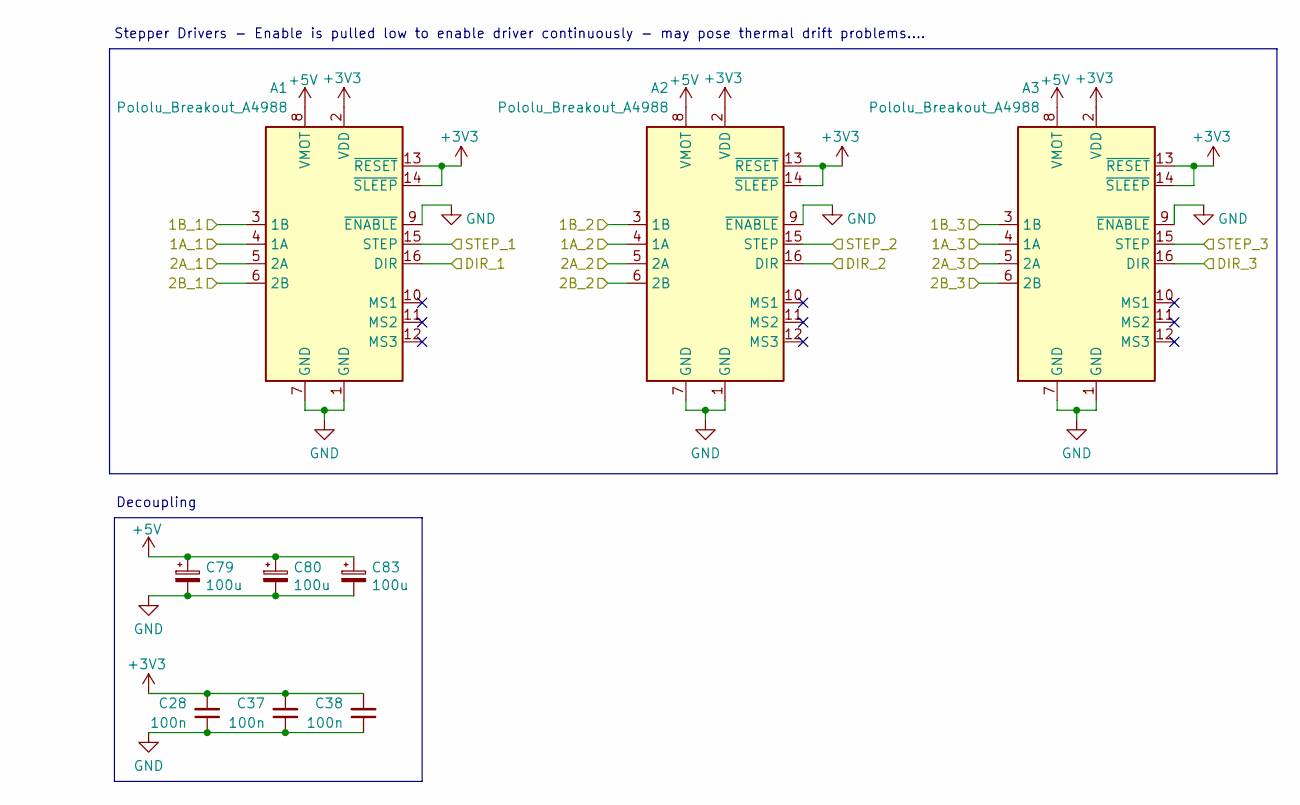
[picture p55: schematic StepperDrivers.kicad_sch]

Parts:
A1, A2, A3: Pololu_Breakout_A4988; Pololu_Breakout-16_15.2x20.3mm
C28, C37, C38: 100n; C_0805_2012Metric; Mouser Part Number 80-C0805S104K1RACAUT
C79, C80, C83: 100u; CP_Radial_D6.3mm_P2.50mm; Mouser Part Number 80-ESW107M016AE3EA

Connections:
+3V3: A1.2 (VDD), A1.13 (~RESET), A1.14 (~SLEEP), A2.2 (VDD), A2.13 (~RESET), A2.14 (~SLEEP), A3.2 (VDD), A3.13 (~RESET), A3.14 (~SLEEP), C28.2, C37.2, C38.2; also elsewhere on the board
+5V: A1.8 (VMOT), A2.8 (VMOT), A3.8 (VMOT), C79.1, C80.1, C83.1; also elsewhere on the board
/1A_1: A1.4 (1A); also elsewhere on the board
/1A_2: A2.4 (1A); also elsewhere on the board
/1A_3: A3.4 (1A); also elsewhere on the board
/1B_1: A1.3 (1B); also elsewhere on the board
/1B_2: A2.3 (1B); also elsewhere on the board
/1B_3: A3.3 (1B); also elsewhere on the board
/2A_1: A1.5 (2A); also elsewhere on the board
/2A_2: A2.5 (2A); also elsewhere on the board
/2A_3: A3.5 (2A); also elsewhere on the board
/2B_1: A1.6 (2B); also elsewhere on the board
/2B_2: A2.6 (2B); also elsewhere on the board
/2B_3: A3.6 (2B); also elsewhere on the board
/StepperDrivers/DIR_1: A1.16 (DIR); also elsewhere on the board
/StepperDrivers/DIR_2: A2.16 (DIR); also elsewhere on the board
/StepperDrivers/DIR_3: A3.16 (DIR); also elsewhere on the board
/StepperDrivers/STEP_1: A1.15 (STEP); also elsewhere on the board
/StepperDrivers/STEP_2: A2.15 (STEP); also elsewhere on the board
/StepperDrivers/STEP_3: A3.15 (STEP); also elsewhere on the board
GND: A1.1 (GND), A1.7 (GND), A1.9 (~ENABLE), A2.1 (GND), A2.7 (GND), A2.9 (~ENABLE), A3.1 (GND), A3.7 (GND), A3.9 (~ENABLE), C28.1, C37.1, C38.1, C79.2, C80.2, C83.2; also elsewhere on the board

Notes on the sheet:
Stepper Drivers - Enable is pulled low to enable driver continuously - may pose thermal drift problems....
Decoupling

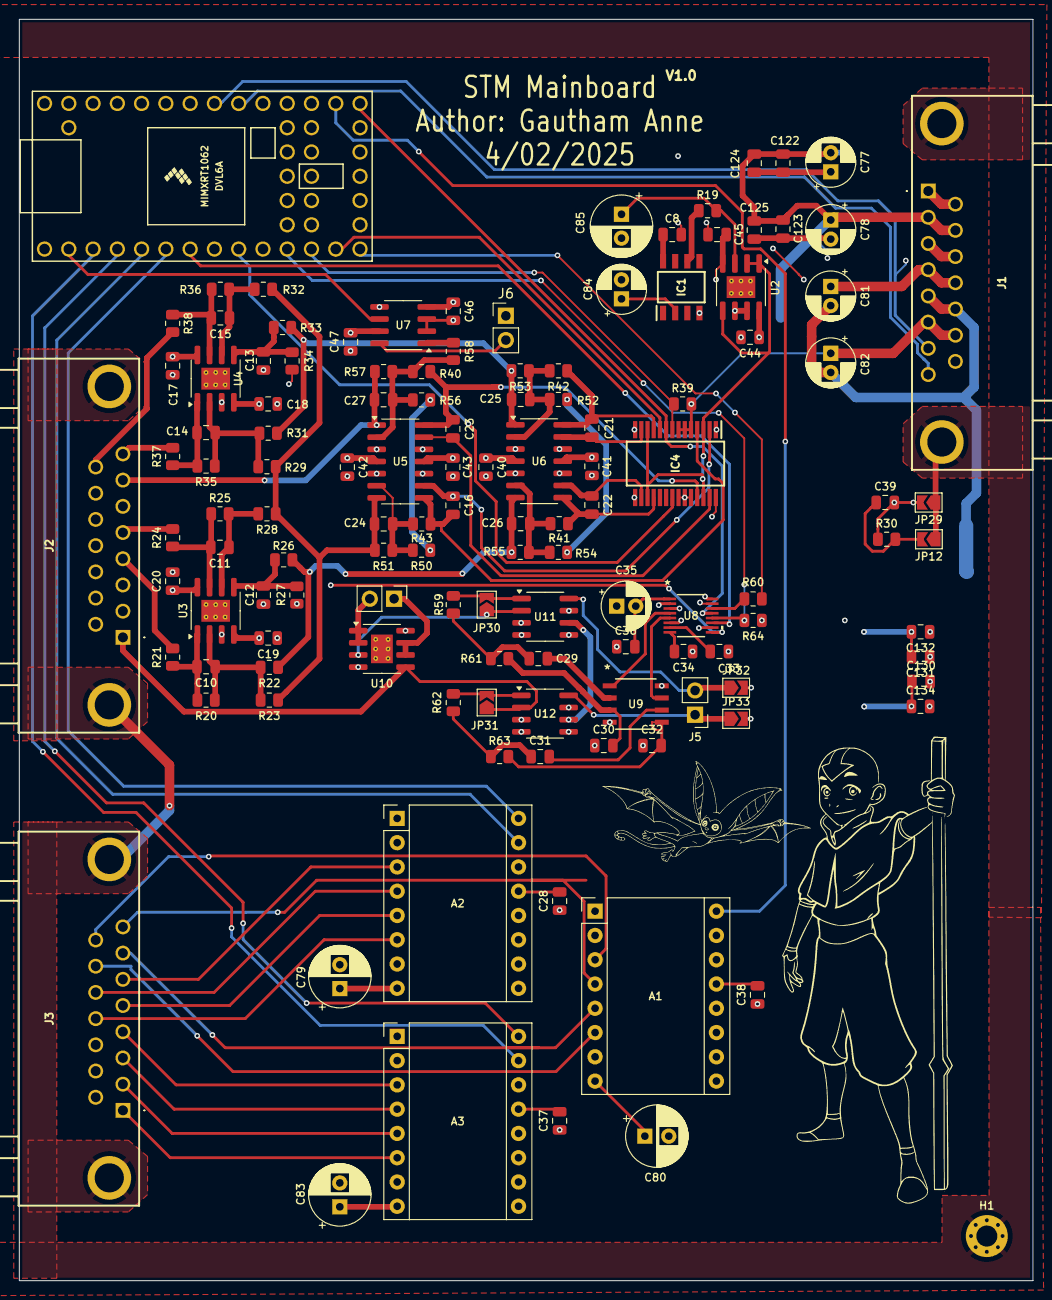
[picture p56: board Mainboard.kicad_pcb from above]

Board: 4 copper layers, 106.1 x 132.0 mm, 126 parts (0 on the bottom side), 94 nets.
