annegautham/STM/(commit log)

2025-02-08 pre amp addition
    [STM_Preamp.kicad_pcb, STM_Preamp.kicad_sch]
2025-02-12 tunneling amp v1.0 commit
    [STM_Preamp.kicad_pcb, STM_Preamp.kicad_sch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]
2025-02-18 Sent in V1.0 to JLC
    [Tunnleing_Amp-B_Cu.gbl, Tunnleing_Amp-B_Mask.gbs, Tunnleing_Amp-B_Paste.gbp, Tunnleing_Amp-B_Silkscreen.gbo, Tunnleing_Amp-Edge_Cuts.gm1, Tunnleing_Amp-F_Cu.gtl, Tunnleing_Amp-F_Mask.gts, Tunnleing_Amp-F_Paste.gtp]
2025-03-03 Power Supply Requirements
    [Power_Supply.kicad_pcb, Power_Supply.kicad_sch]
2025-04-02 updates to Spice Model, Power Supply Design
    [Case.SLDPRT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]
2025-04-04 Enclosure CAD V1
    [40x40x10 DC Fan.SLDPRT, Case.SLDPRT, FLN_40_18_model.SLDPRT, FLN_40_18_model.STEP, Power Entry AC 10A 250V IEC320 C14 Illuminated.STEP, Power_Supply.kicad_pcb, Power_Supply_Case.SLDPRT]
2025-04-07 Analog Circuit V1.0
    [ADC.kicad_sch, Connectors.kicad_sch, DAC.kicad_sch, Mainboard.kicad_pcb, Mainboard.kicad_sch, PiezoDriver.kicad_sch, Power.kicad_sch, Power_Supply.kicad_pcb]
2025-04-13 Mainboard grind
    [ADC.kicad_sch, Connectors.kicad_sch, DAC.kicad_sch, Flat pattern - Power_Supply_Case.DXF, Flat pattern - TopCover.DXF, Mainboard.kicad_pcb, Mainboard.kicad_sch, PiezoDriver.kicad_sch]
2025-04-18 CAD updates
    [10151976.stp, 28BYJ-48 body.SLDPRT, 28BYJ-48 cover plate.SLDPRT, 28BYJ-48 plastic.SLDPRT, 28BYJ-48 shaft.SLDPRT, 28BYJ-48 stepper motor ASSEMBLY PART.SLDPRT, 28BYJ-48 stepper motor ASSEMBLY.SLDASM, 28BYJ-48 stepper motor.IGS]
2025-04-23 updates! scan head cad
    [Base.SLDPRT, Top.SLDPRT, Tunnleing_Amp.kicad_pcb, top_polycarb.SLDPRT, tunneling_amp_insulation.SLDPRT]
2025-04-29 working mainboard push!
    [ADC.kicad_sch, Connectors.kicad_sch, DAC.kicad_sch, Mainboard.kicad_pcb, Mainboard.kicad_sch, PiezoDriver.kicad_sch, Power.kicad_sch, StepperDrivers.kicad_sch]
2025-04-29 more push
    [Mainboard.kicad_pcb]
2025-04-30 mainboard working commits!
    [ADC.kicad_sch, Connectors.kicad_sch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]
2025-05-01 more pushing!
    [Base.SLDPRT]
2025-05-02 final assembly updates!
    [5in_plate.SLDPRT, Mainboard.kicad_pcb, aluminum_baseplate.SLDPRT, hd_magnet.SLDPRT, mdf_base.SLDPRT, mdf_ground.SLDPRT, oring.SLDPRT]
2025-05-02 bom updates!
2025-05-03 mainboard update
    [DAC.kicad_sch]
2025-05-08 cad update
    [Connectors.kicad_sch, DAC.kicad_sch, Mainboard.kicad_pcb, PiezoDriver.kicad_sch, StepperDrivers.kicad_sch, Top.SLDDRW, Top.SLDPRT, TopCover.SLDPRT]
2025-05-16 collet stl
    [collet.SLDPRT, collet.STL]
2025-05-18 collet stls
    [collet.SLDPRT, collet.STL]
2025-05-18 directory updates
    [STM.GBL, STM.GBO, STM.GBS, STM.GKO, STM.GTL, STM.GTO, STM.GTS]
2025-05-28 cad work
    [TopCover.SLDPRT, TopCover.STL]
2025-05-28 top cover stl
    [TopCover.SLDPRT, TopCover.STL]
2025-05-29 caddy cad updates
    [Mainboard.kicad_pcb, casing.3mf, casing.SLDPRT, casing.STL, tipGuard.SLDPRT, tipGuard.STL]
2025-05-30 control loopsies
    [Top.SLDPRT, casing.3mf, casing.SLDPRT, casing.STL]
2025-11-16 documentation updartes
    [Mainboard.csv, Mainboard.kicad_pcb, Power_Supply.kicad_sch, spider.SLDPRT, support_mot_pap.SLDPRT]
2026-09-08 tunneling amp repo rename
    [Tunnleing_Amp-B_Cu.gbl, Tunnleing_Amp-B_Mask.gbs, Tunnleing_Amp-B_Paste.gbp, Tunnleing_Amp-B_Silkscreen.gbo, Tunnleing_Amp-Edge_Cuts.gm1, Tunnleing_Amp-F_Cu.gtl, Tunnleing_Amp-F_Mask.gts, Tunnleing_Amp-F_Paste.gtp]
